mikaelrobertlindberg/elec_RPI_Robot_HAT/production/M2/U8_only_change.png

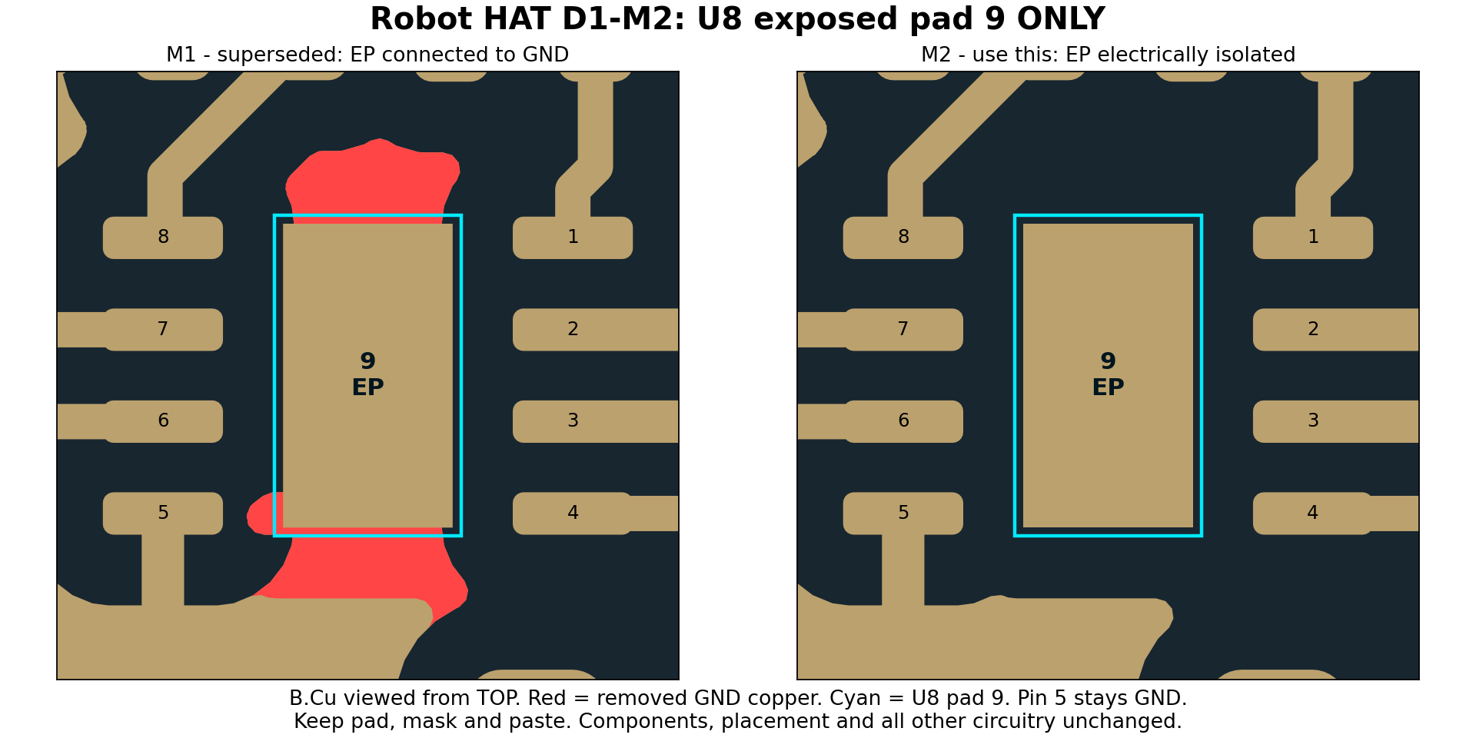
production/M2/U8_only_change.png
