mikaelrobertlindberg/elec_RPI_Robot_HAT/production/M2/BOM_PCBA_10.csv

Item | Designators | Quantity per board | Quantity for 10 boards | Manufacturer | Manufacturer Part Number | Value | Footprint | LCSC Part Number | Source | Source URL | Stock checked | Observed stock | Populate
1 | C1, C2, C3, C4, C6, C10, C27, C29, C31, C33, C35, C40, C41, C42, C43 | 15 | 150 | SAMSUNG(三星) | CL05A105KA5NQNC | 1u | RobotHAT:C_0402_1005Metric_C1 / RobotHAT:C_0402_1005Metric_C10 / RobotHAT:C_0402_1005Metric_C2 / RobotHAT:C_0402_1005Metric_C27 / RobotHAT:C_0402_1005Metric_C29 / RobotHAT:C_0402_1005Metric_C3 / RobotHAT:C_0402_1005Metric_C31 / RobotHAT:C_0402_1005Metric_C33 / RobotHAT:C_0402_1005Metric_C35 / RobotHAT:C_0402_1005Metric_C4 / RobotHAT:C_0402_1005Metric_C40 / RobotHAT:C_0402_1005Metric_C41 / RobotHAT:C_0402_1005Metric_C42 / RobotHAT:C_0402_1005Metric_C43 / RobotHAT:C_0402_1005Metric_C6 | C52923 | LCSC | https://www.lcsc.com/product-detail/C52923.html | 2026-11-09 | 2908400 | YES
2 | C5, C7, C12, C13, C37 | 5 | 50 | SAMSUNG(三星) | CL10A106MQ8NNNC | 10u | RobotHAT:C_0603_1608Metric_C12 / RobotHAT:C_0603_1608Metric_C13 / RobotHAT:C_0603_1608Metric_C37 / RobotHAT:C_0603_1608Metric_C5 / RobotHAT:C_0603_1608Metric_C7 | C1691 | LCSC | https://www.lcsc.com/product-detail/C1691.html | 2026-11-09 | 491910 | YES
3 | C8, C9 | 2 | 20 | muRata(村田) | GRM1555C1H221JA01D | 220p 50V C0G | RobotHAT:C_0402_1005Metric_C8 / RobotHAT:C_0402_1005Metric_C9 | C71693 | LCSC | https://www.lcsc.com/product-detail/C71693.html | 2026-11-09 | 1193500 | YES
4 | C11, C14, C15, C16, C17, C18, C20, C26, C28, C30, C32, C36, C38 | 13 | 130 | SAMSUNG(三星) | CL05B104KB54PNC | 100n / 100n 50V | RobotHAT:C_0402_1005Metric_C11 / RobotHAT:C_0402_1005Metric_C14 / RobotHAT:C_0402_1005Metric_C15 / RobotHAT:C_0402_1005Metric_C16 / RobotHAT:C_0402_1005Metric_C17 / RobotHAT:C_0402_1005Metric_C18 / RobotHAT:C_0402_1005Metric_C20 / RobotHAT:C_0402_1005Metric_C26 / RobotHAT:C_0402_1005Metric_C28 / RobotHAT:C_0402_1005Metric_C30 / RobotHAT:C_0402_1005Metric_C32 / RobotHAT:C_0402_1005Metric_C36 / RobotHAT:C_0402_1005Metric_C38 | C307331 | LCSC | https://www.lcsc.com/product-detail/C307331.html | 2026-11-09 | 2506000 | YES
5 | C19 | 1 | 10 | Panasonic | EEE-FK1J100P | 10u 63V | RobotHAT:Panasonic_FK_D_6.3x5.8_C19 |  | DigiKey | https://www.digikey.se/en/products/detail/panasonic-industry/EEE-FK1J100P/765987 | 2026-11-09 | 14595 | YES
6 | C21, C22 | 2 | 20 | Murata | GRM31CR61C476ME44L | 47u 16V | RobotHAT:C_1206_C21 / RobotHAT:C_1206_C22 | C385047 | LCSC | https://www.lcsc.com/product-detail/C385047.html | 2026-11-09 | 1833 | YES
7 | C23, C24 | 2 | 20 | SAMSUNG(三星) | CL05B104KO5NNNC | 100n 16V | RobotHAT:C_0402_1005Metric_C23 / RobotHAT:C_0402_1005Metric_C24 | C1525 | LCSC | https://www.lcsc.com/product-detail/C1525.html | 2026-11-09 | 3026000 | YES
8 | C34, C44 | 2 | 20 | SAMSUNG(三星) | CL05B103KB5NNNC | 10n | RobotHAT:C_0402_1005Metric_C34 / RobotHAT:C_0402_1005Metric_C44 | C15195 | LCSC | https://www.lcsc.com/product-detail/C15195.html | 2026-11-09 | 968700 | YES
9 | C39 | 1 | 10 | Murata | GRM21BR71H224KA01L | 220n 50V | RobotHAT:C_0805_C39 | C86042 | LCSC | https://www.lcsc.com/product-detail/C86042.html | 2026-11-09 | 6175 | YES
10 | C45 | 1 | 10 | Chinocera(华瓷) | HGC0805R5106K350NSLJ | 10u 35V | RobotHAT:C_0805_2012Metric_C45 | C33546007 | LCSC | https://www.lcsc.com/product-detail/C33546007.html | 2026-11-09 | 379510 | YES
11 | D1 | 1 | 10 | onsemi | BAT54WT1G | BAT54W | RobotHAT:SOT-323_SC-70_D1 |  | DigiKey | https://www.digikey.se/en/products/detail/onsemi/BAT54WT1G/918320 | 2026-11-09 | 429 | YES
12 | D2 | 1 | 10 | R+O(宏嘉诚) | BZT52B3V3 | 3V3 Zener Diode | RobotHAT:D_SOD-123_D2 | C19077392 | LCSC | https://www.lcsc.com/product-detail/C19077392.html | 2026-11-09 | 270940 | YES
13 | D4 | 1 | 10 | DIODES(美台) | BZT52C5V1S-7-F | 5V1 | RobotHAT:D_SOD-323_D4 | C151348 | LCSC | https://www.lcsc.com/product-detail/C151348.html | 2026-11-09 | 56280 | YES
14 | D5 | 1 | 10 | Diodes Incorporated | SBR3U40P1-7 | SBR3U40P1-7 | RobotHAT:D_PowerDI123_D5 | C97127 | LCSC | https://www.lcsc.com/product-detail/C97127.html | 2026-11-09 | 9655 | YES
15 | FB1 | 1 | 10 | muRata(村田) | BLM15AG601SN1D | 0.3A 600R@100MHz | RobotHAT:L_0402_1005Metric_FB1 | C76884 | LCSC | https://www.lcsc.com/product-detail/C76884.html | 2026-11-09 | 748800 | YES
16 | FB2, FB3 | 2 | 20 | muRata(村田) | BLM15PX121SN1D | 2A - 120R@100MHz | RobotHAT:L_0402_1005Metric_FB2 / RobotHAT:L_0402_1005Metric_FB3 | C88970 | DigiKey | https://www.digikey.se/en/products/detail/murata-electronics/BLM15PX121SN1D/4421095 | 2026-11-09 | 173030 | YES
17 | J1, J2, J9 | 3 | 30 | DORABO(地博电气) | DB125-2.54-2P-GN-S | Screw term. | RobotHAT:CONN-TH_DB125-2.54-2P-GN_J1 / RobotHAT:CONN-TH_DB125-2.54-2P-GN_J2 / RobotHAT:CONN-TH_DB125-2.54-2P-GN_J9 | C918120 | LCSC | https://www.lcsc.com/product-detail/C918120.html | 2026-11-09 | 28940 | YES
18 | J3, J11 | 2 | 20 | JST | B4B-EH-A(LF)(SN) | Dynamixel-4 | RobotHAT:JST_EH_B4B-EH-A_1x04_P2.50mm_Vertical_J11 / RobotHAT:JST_EH_B4B-EH-A_1x04_P2.50mm_Vertical_J3 | C160258 | LCSC | https://www.lcsc.com/product-detail/C160258.html | 2026-11-09 | 42240 | YES
19 | J4 | 1 | 10 | Liansheng(连盛) | FH-00339 | Female Header 2x20 SMD | RobotHAT:PinHeader_2x20_P2.54mm_Vertical_with_rasp_HAT_zero_SMD_connector_J4 | C2685112 | LCSC | https://www.lcsc.com/product-detail/C2685112.html | 2026-11-09 | 8387 | YES
20 | J5, J6, J7, J8 | 4 | 40 | JST | BM04B-SRSS-TB(LF)(SN) | JST SH | RobotHAT:JST_SH_BM04B-SRSS-TB_1x04-1MP_P1.00mm_Vertical_J5 / RobotHAT:JST_SH_BM04B-SRSS-TB_1x04-1MP_P1.00mm_Vertical_J6 / RobotHAT:JST_SH_BM04B-SRSS-TB_1x04-1MP_P1.00mm_Vertical_J7 / RobotHAT:JST_SH_BM04B-SRSS-TB_1x04-1MP_P1.00mm_Vertical_J8 | C160390 | LCSC | https://www.lcsc.com/product-detail/C160390.html | 2026-11-09 | 1645 | YES
21 | J13, J14 | 2 | 20 | JST | B3B-EH-A(LF)(SN) | Dynamixel-3 | RobotHAT:JST_EH_B3B-EH-A_1x03_P2.50mm_Vertical_J13 / RobotHAT:JST_EH_B3B-EH-A_1x03_P2.50mm_Vertical_J14 | C160259 | LCSC | https://www.lcsc.com/product-detail/C160259.html | 2026-11-09 | 73430 | YES
22 | L4 | 1 | 10 | Eaton | SDCHA1V6045-4R7-R | 4u7 4.5A | RobotHAT:Eaton_SDCHA1V6045_L4 |  | DigiKey | https://www.digikey.se/en/products/detail/eaton-electronics-division/SDCHA1V6045-4R7-R/15926156 | 2026-11-09 | 4455 | YES
23 | MK1 | 1 | 10 | LinkMems(聆麦声学) | LMA2718T421-OA5-2 | Microphone_MEMS | RobotHAT:MIC-SMD_4P-L2.8-W1.9-P1.84-TL_MK1 | C7587901 | LCSC | https://www.lcsc.com/product-detail/C7587901.html | 2026-11-09 | 9870 | YES
24 | Q1 | 1 | 10 | TWGMC(迪嘉) | MMBT3906 | MMBT3906 | RobotHAT:SOT-23_Q1 | C727128 | LCSC | https://www.lcsc.com/product-detail/C727128.html | 2026-11-09 | 313450 | YES
25 | Q2 | 1 | 10 | Diodes Incorporated | DMN3023L-7 | DMN3023L-7 | RobotHAT:TSOT-23_Q2 | C443825 | LCSC | https://www.lcsc.com/product-detail/C443825.html | 2026-11-09 | 7645 | YES
26 | R1, R2, R6, R12, R13, R20, R21, R24, R26, R27, R29, R31, R32, R34, R35, R38, R39 | 17 | 170 | UNI-ROYAL(厚声) | 0402WGF1002TCE | 10k | RobotHAT:R_0402_1005Metric_R1 / RobotHAT:R_0402_1005Metric_R12 / RobotHAT:R_0402_1005Metric_R13 / RobotHAT:R_0402_1005Metric_R2 / RobotHAT:R_0402_1005Metric_R20 / RobotHAT:R_0402_1005Metric_R21 / RobotHAT:R_0402_1005Metric_R24 / RobotHAT:R_0402_1005Metric_R26 / RobotHAT:R_0402_1005Metric_R27 / RobotHAT:R_0402_1005Metric_R29 / RobotHAT:R_0402_1005Metric_R31 / RobotHAT:R_0402_1005Metric_R32 / RobotHAT:R_0402_1005Metric_R34 / RobotHAT:R_0402_1005Metric_R35 / RobotHAT:R_0402_1005Metric_R38 / RobotHAT:R_0402_1005Metric_R39 / RobotHAT:R_0402_1005Metric_R6 | C25744 | LCSC | https://www.lcsc.com/product-detail/C25744.html | 2026-11-09 | 1442800 | YES
27 | R3, R4, R5, R7, R9, R14, R15, R18, R19, R25, R30, R40 | 12 | 120 | UNI-ROYAL(厚声) | 0402WGF0000TCE | 0R | RobotHAT:R_0402_1005Metric_R14 / RobotHAT:R_0402_1005Metric_R15 / RobotHAT:R_0402_1005Metric_R18 / RobotHAT:R_0402_1005Metric_R19 / RobotHAT:R_0402_1005Metric_R25 / RobotHAT:R_0402_1005Metric_R3 / RobotHAT:R_0402_1005Metric_R30 / RobotHAT:R_0402_1005Metric_R4 / RobotHAT:R_0402_1005Metric_R40 / RobotHAT:R_0402_1005Metric_R5 / RobotHAT:R_0402_1005Metric_R7 / RobotHAT:R_0402_1005Metric_R9 | C17168 | LCSC | https://www.lcsc.com/product-detail/C17168.html | 2026-11-09 | 8561100 | YES
28 | R22, R23 | 2 | 20 | YAGEO(国巨) | RC0402FR-074K7L | 4k7 | RobotHAT:R_0402_1005Metric_R22 / RobotHAT:R_0402_1005Metric_R23 | C105871 | LCSC | https://www.lcsc.com/product-detail/C105871.html | 2026-11-09 | 11573800 | YES
29 | R28 | 1 | 10 | UNI-ROYAL(厚声) | 0402WGF2002TCE | 20k | RobotHAT:R_0402_1005Metric_R28 | C25765 | LCSC | https://www.lcsc.com/product-detail/C25765.html | 2026-11-09 | 699600 | YES
30 | R33 | 1 | 10 | FOJAN(富捷) | FRC0402F1500TS | 150R | RobotHAT:R_0402_1005Metric_R33 | C2909321 | LCSC | https://www.lcsc.com/product-detail/C2909321.html | 2026-11-09 | 867900 | YES
31 | R42 | 1 | 10 | YAGEO(国巨) | RC0402JR-071KL | 1k | RobotHAT:R_0402_1005Metric_R42 | C105637 | LCSC | https://www.lcsc.com/product-detail/C105637.html | 2026-11-09 | 17128500 | YES
32 | TH1 | 1 | 10 | muRata(村田) | PRG18BB101MB1RB | 100R thermistor | RobotHAT:R_0603_1608Metric_TH1 | C913703 | LCSC | https://www.lcsc.com/product-detail/C913703.html | 2026-11-09 | 1935 | YES
33 | U1 | 1 | 10 | DIODES(美台) | PAM8406DR | PAM8406D | RobotHAT:SOIC-16_3.9x9.9mm_P1.27mm_U1 | C86270 | LCSC | https://www.lcsc.com/product-detail/C86270.html | 2026-11-09 | 20597 | YES
34 | U2 | 1 | 10 | TI(德州仪器) | TLV320AIC3104IRHBR | TLV320AIC3104IRHBR | RobotHAT:VQFN-32-1EP_5x5mm_P0.5mm_EP3.5x3.5mm_U2 | C181753 | LCSC | https://www.lcsc.com/product-detail/C181753.html | 2026-11-09 | 7355 | YES
35 | U3 | 1 | 10 | UMW(友台半导体) | XC6206P182MR | XC6206P182MR | RobotHAT:SOT-23-3_U3 | C347373 | LCSC | https://www.lcsc.com/product-detail/C347373.html | 2026-11-09 | 53350 | YES
36 | U5 | 1 | 10 | TI(德州仪器) | SN74LVC1G08DBVR | 74LVC1G08 | RobotHAT:SOT-23-5_U5 | C7666 | LCSC | https://www.lcsc.com/product-detail/C7666.html | 2026-11-09 | 86350 | YES
37 | U6 | 1 | 10 | TI(德州仪器) | SN74LVC1G125DBVR | SN74LVC1G125DBV | RobotHAT:SOT-23-5_U6 | C23654 | LCSC | https://www.lcsc.com/product-detail/C23654.html | 2026-11-09 | 182035 | YES
38 | U7 | 1 | 10 | TI(德州仪器) | SN74LVC1G126DBVR | SN74LVC1G126DBVR | RobotHAT:SOT-23-5_U7 | C7834 | LCSC | https://www.lcsc.com/product-detail/C7834.html | 2026-11-09 | 84300 | YES
39 | U8 | 1 | 10 | GATEMODE(捷茂微) | GM3088ENA | GM3088ENA | RobotHAT:DFN-8-1EP_3x3mm_P0.65mm_EP1.2x2.15mm_U8 | C49423279 | LCSC | https://www.lcsc.com/product-detail/C49423279.html | 2026-11-09 | 42380 | YES
40 | U9 | 1 | 10 | DIODES(美台) | AP63205WU-7 | AP63205 | RobotHAT:TSOT-23-6_U9 | C2071056 | LCSC | https://www.lcsc.com/product-detail/C2071056.html | 2026-11-09 | 41129 | YES
41 | U10 | 1 | 10 | Texas Instruments | LM74700QDBVRQ1 | LM74700QDBVRQ1 | RobotHAT:LM74700_DBV_U10 | C2941042 | LCSC | https://www.lcsc.com/product-detail/C2941042.html | 2026-11-09 | 20538 | YES
42 | U12 | 1 | 10 | ST(意法半导体) | LSM6DSV16XTR | LSM6DSV16XTR | RobotHAT:LSM6DSV16X_PCBWay_020_U12 | C5267406 | LCSC | https://www.lcsc.com/product-detail/C5267406.html | 2026-11-09 | 11047 | YES
43 | Y1 | 1 | 10 | YXC(扬兴晶振) | OT3EL89CJI-111YLC-12M | 12 MHz | RobotHAT:Oscillator_SMD_Abracon_ASDMB-4Pin_2.5x2.0mm_Y1 | C7425459 | LCSC | https://www.lcsc.com/product-detail/C7425459.html | 2026-11-09 | 5750 | YES
