mikaelrobertlindberg/elec_RPI_Robot_HAT/production/M2/docs/ROUTING_REPAIR.md

# Power ECO routing verification — 2026-11-09

KiCad9.0.7 final native DRC at13:02:16: **0 violations,0 unconnected items,0 schematic parity findings**, with all severities included. Report: `repair-final-drc.json`. No rule severity, exclusion, project settings or net functions were changed by this routing repair.

## Copper changes

- Removed the new B.Cu +5V loop that crossed ground traces, ground vias and audio test points; removed the regulator-sense via/track that crossed +BATT on F.Cu.
- +5V Q2 drain now has a1mm outer-copper connection to three0.6mm-diameter/0.3mm-drilled through vias near(101.8,79.7/80.4/81.1). A1.8mm inner-copper trunk reaches the original +5V connection at(108.897501,76.740001), supplemented by two additional0.6/0.3 vias near(108.9,75.2/75.9). The upper branch near TP4 uses0.6mm fan-out width; it carries one of three parallel via currents rather than the entire2A load.
- REG_5V main connection between L4 output copper and Q2 source retains1mm outer-copper width and now has three0.6/0.3 vias near(101.7,82.5/83.0/83.5). No single0.2mm drill is relied upon for this new main power transition.
- U10 ground escapes through its body corridor to a local ground via at(104.65,75.9), clear of the SW trace and adjacent gate/VCAP pads.
- U10 ANODE/EN and C39's ANODE-side return connect to the L4 output/Q2-source net through a narrow sense route and a local REG_5V via at(106.4,82.4).
- D1 cathode joins the sensed regulator output through a via near(98.8,81.4), without crossing VIN copper.
- Both output-capacitor ground pads receive direct0.6/0.3 ground vias at(97.925,82.9) and(93.025,82.9). This connects the bottom-edge ground pour that the new power traces had isolated and shortens capacitor return paths.
- U8 EP pad9 is assigned GND to match the revised exact-part symbol. The unnumbered paste-only aperture was retained.
- L4's six assembly-outline segments that printed over the enlarged exposed lands were moved to F.Fab, preserving their assembly information while eliminating silkscreen-over-mask findings. Its local footprint copy was updated to match.

## Metadata correction caught by native parity

The first routing-clean report exposed52 remaining DNP mismatches despite individual audio symbols having `(dnp no)`. The complete Audio hierarchical sheet had inadvertently become `(dnp yes)` during an earlier schema metadata edit. This was corrected by the parent agent, rather than copying that erroneous population state to the PCB. Only the intended six logo/test-point DNP flags were synchronized on the PCB. Native parity subsequently became0.

## Thermal and return-path interpretation

Outer main power traces are1mm on35um copper. The inner main trunk is1.8mm on18um copper, giving a comparable copper cross-section. Via groups contain three0.3mm drilled barrels per transition; actual current sharing and final copper plating remain manufacturing-dependent. Native checks do not establish a thermal rating or replace a2A load/temperature test.

At the13:02 routing snapshot, the +5V trunk occupies In1.Cu and the narrow REG_5V sense route occupies In2.Cu. The parent was advised that swapping those two **new** route layer assignments, followed by refill and full DRC, would leave the nearest In1 ground reference more continuous beneath the F.Cu SW region and put the broader +5V trunk behind that reference. If that recommendation is applied, the parent's final release reports supersede this routing snapshot.

## Handoff

PCB ownership returned to the parent after the0/0/0 result. No commit was made by this worker. `route_repair_stage2.py` through`stage5.py`, `repair_routes_native.py` and `sync_board_dnp.py` are one-off investigative repair scripts, not a manufacturing release pipeline; they should not be blindly rerun on the final board. Original upstream netclass clearance0.15mm and the dedicated U12 0.19mm constraint were retained.
