mikaelrobertlindberg/elec_RPI_Robot_HAT/production/M2/Robot_HAT_M2_assembly_bottom.pdf

# Robot HAT D1-M2 - bottom assembly

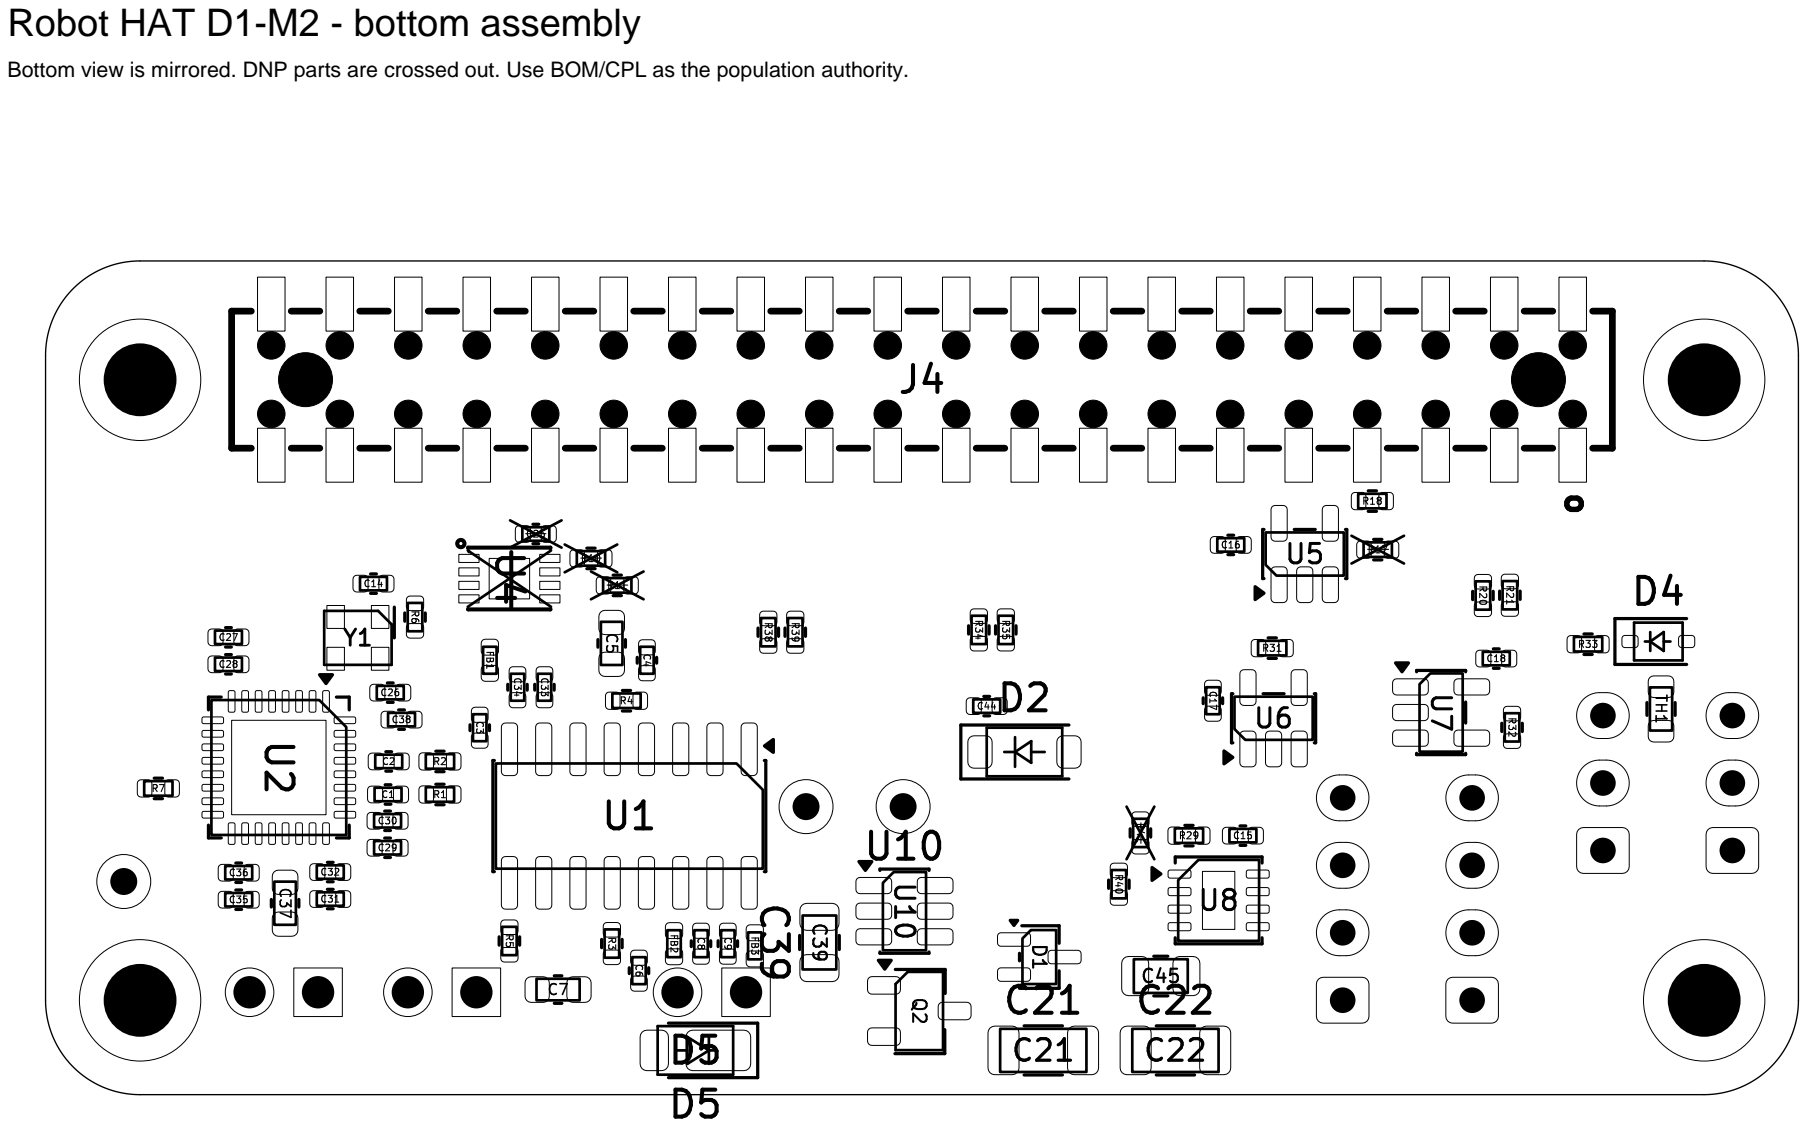
[picture p2: page 1]

Bottom view is mirrored. DNP parts are crossed out. Use BOM/CPL as the population authority.
