mikaelrobertlindberg/elec_RPI_Robot_HAT/production/M2/Robot_HAT_M2_assembly_top.pdf

# Robot HAT D1-M2 - top assembly

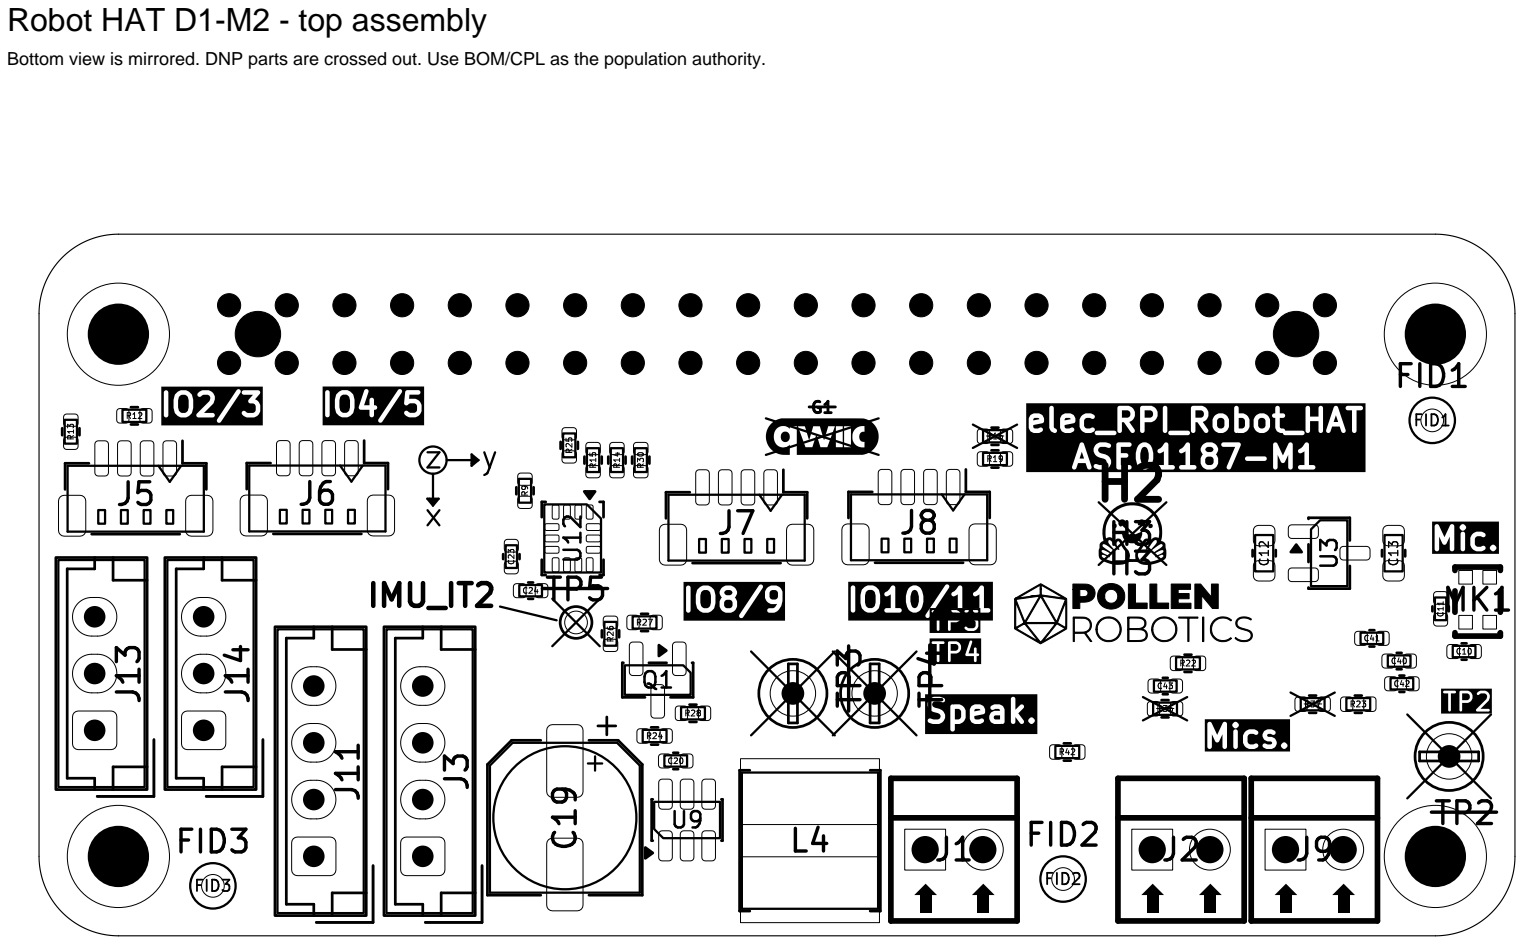
[picture p3: page 1]

Bottom view is mirrored. DNP parts are crossed out. Use BOM/CPL as the population authority.
