mikaelrobertlindberg/elec_RPI_Robot_HAT/production/M2/Robot_HAT_M2_schematic.pdf

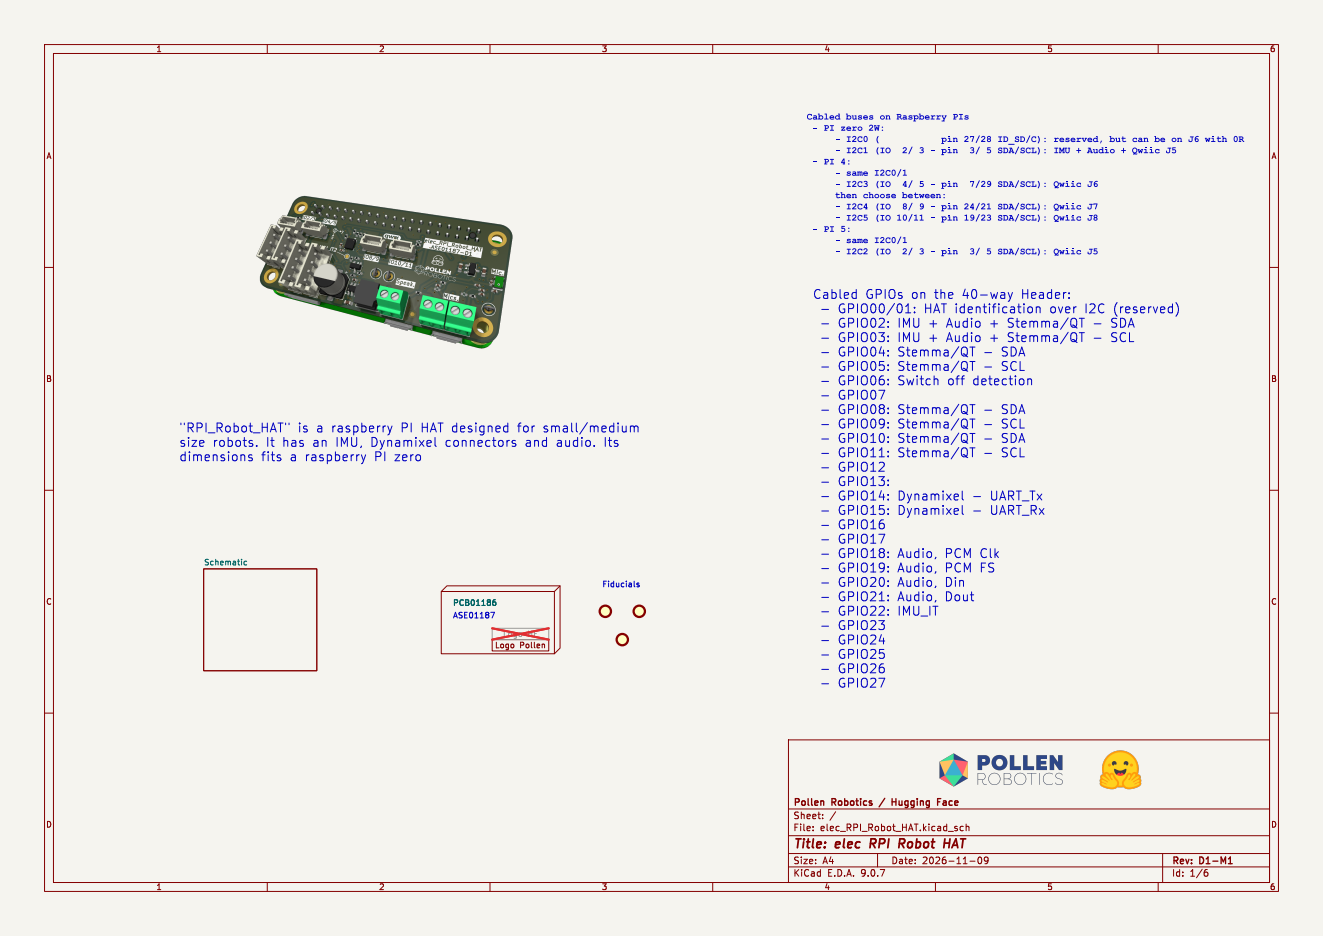
[picture p4: page 1]

Cabled buses on Raspberry PIs
- PI zero 2W:
- same I2C0/1
then choose between:
- I2C5 (IO 10/11 - pin 19/23 SDA/SCL): Qwiic J8

Id: 1/6 Title: elec RPI Robot HAT

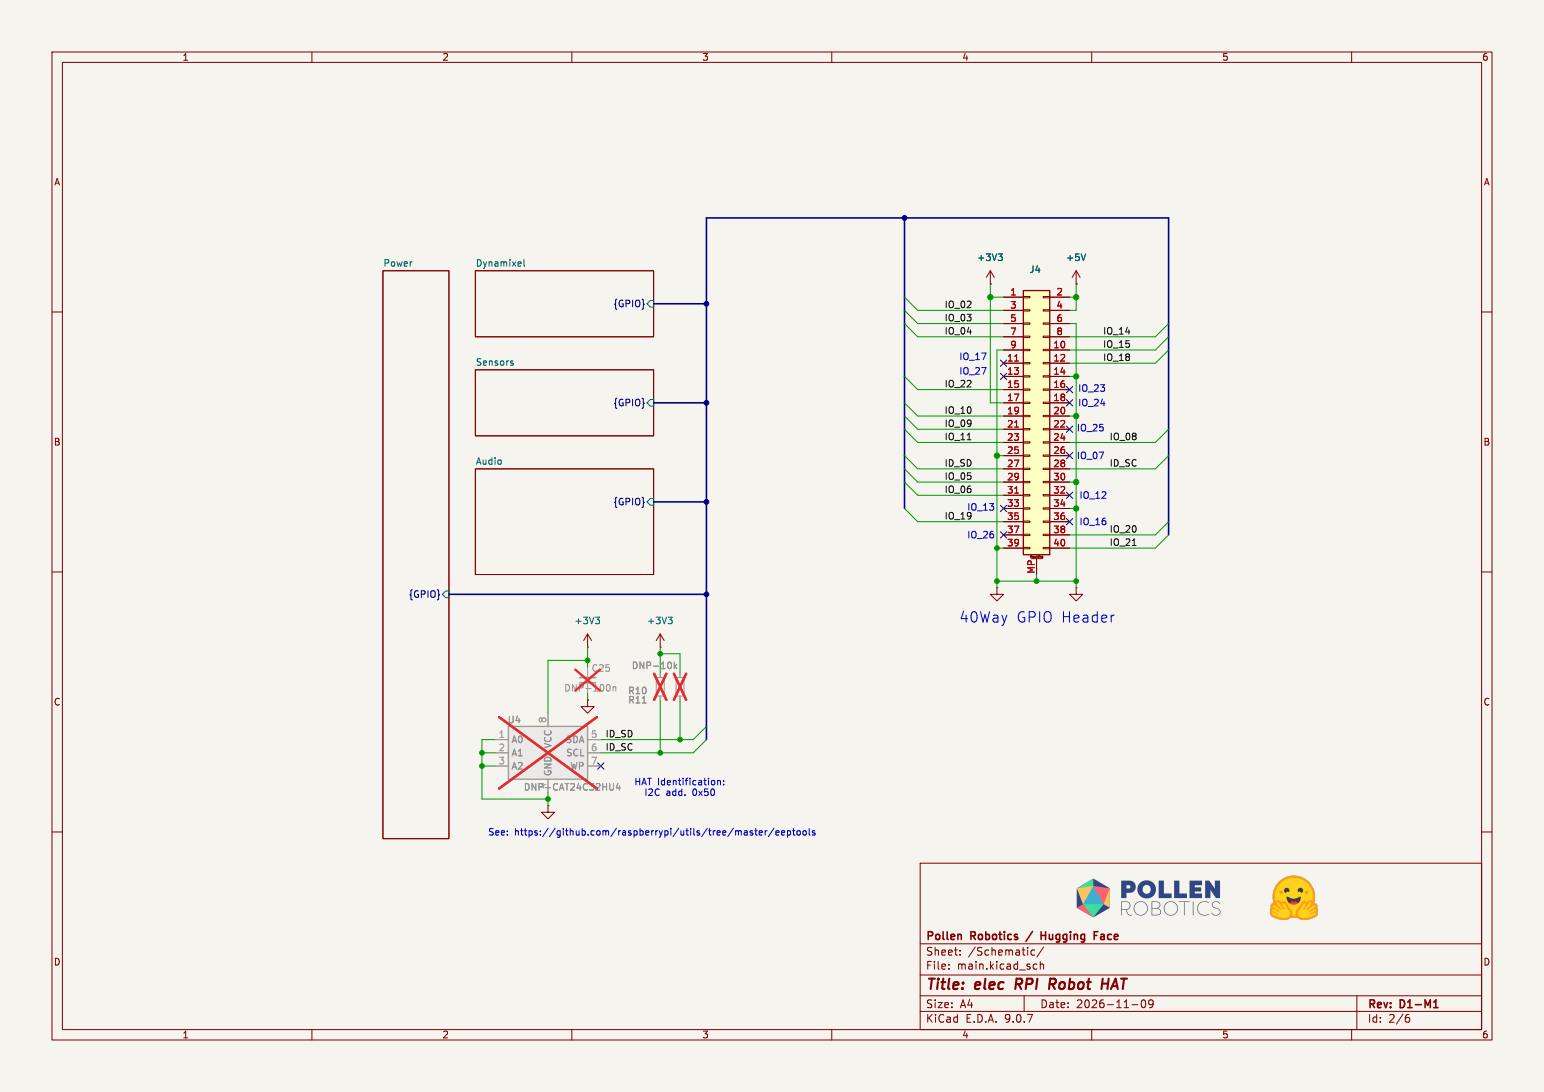
[picture p5: page 2]

I2C add. 0x50 See: https://github.com/raspberrypi/utils/tree/master/eeptools

Id: 2/6 Title: elec RPI Robot HAT

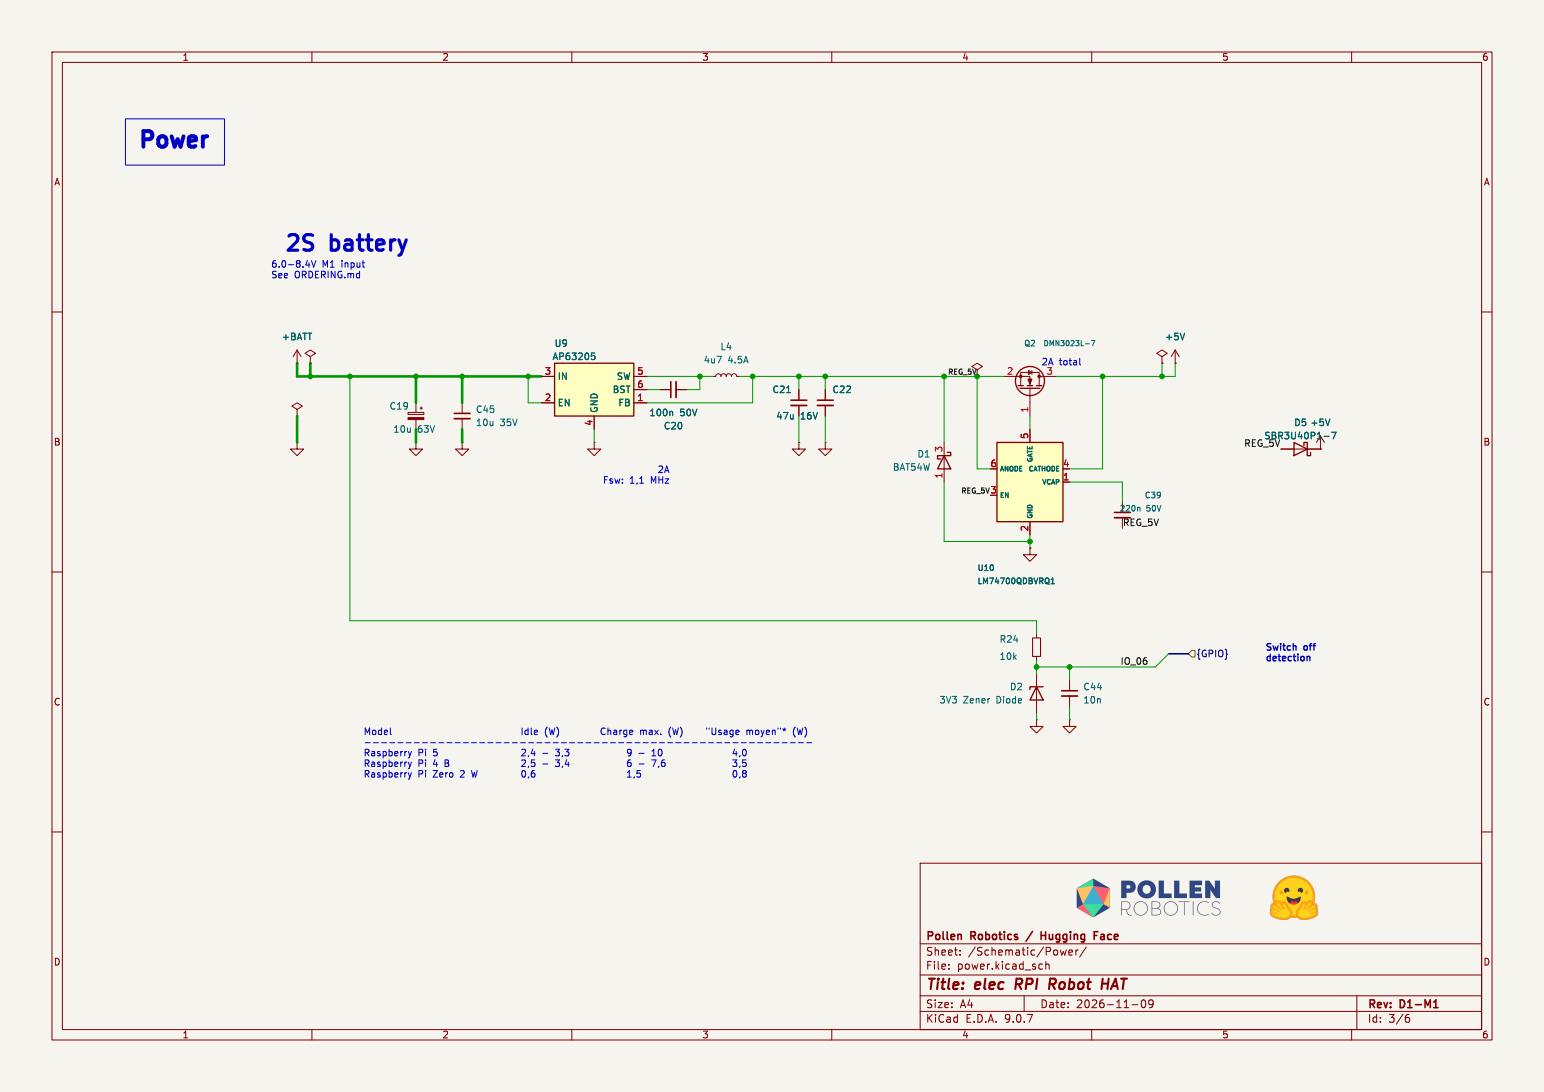
[picture p6: page 3]

Id: 3/6 Title: elec RPI Robot HAT

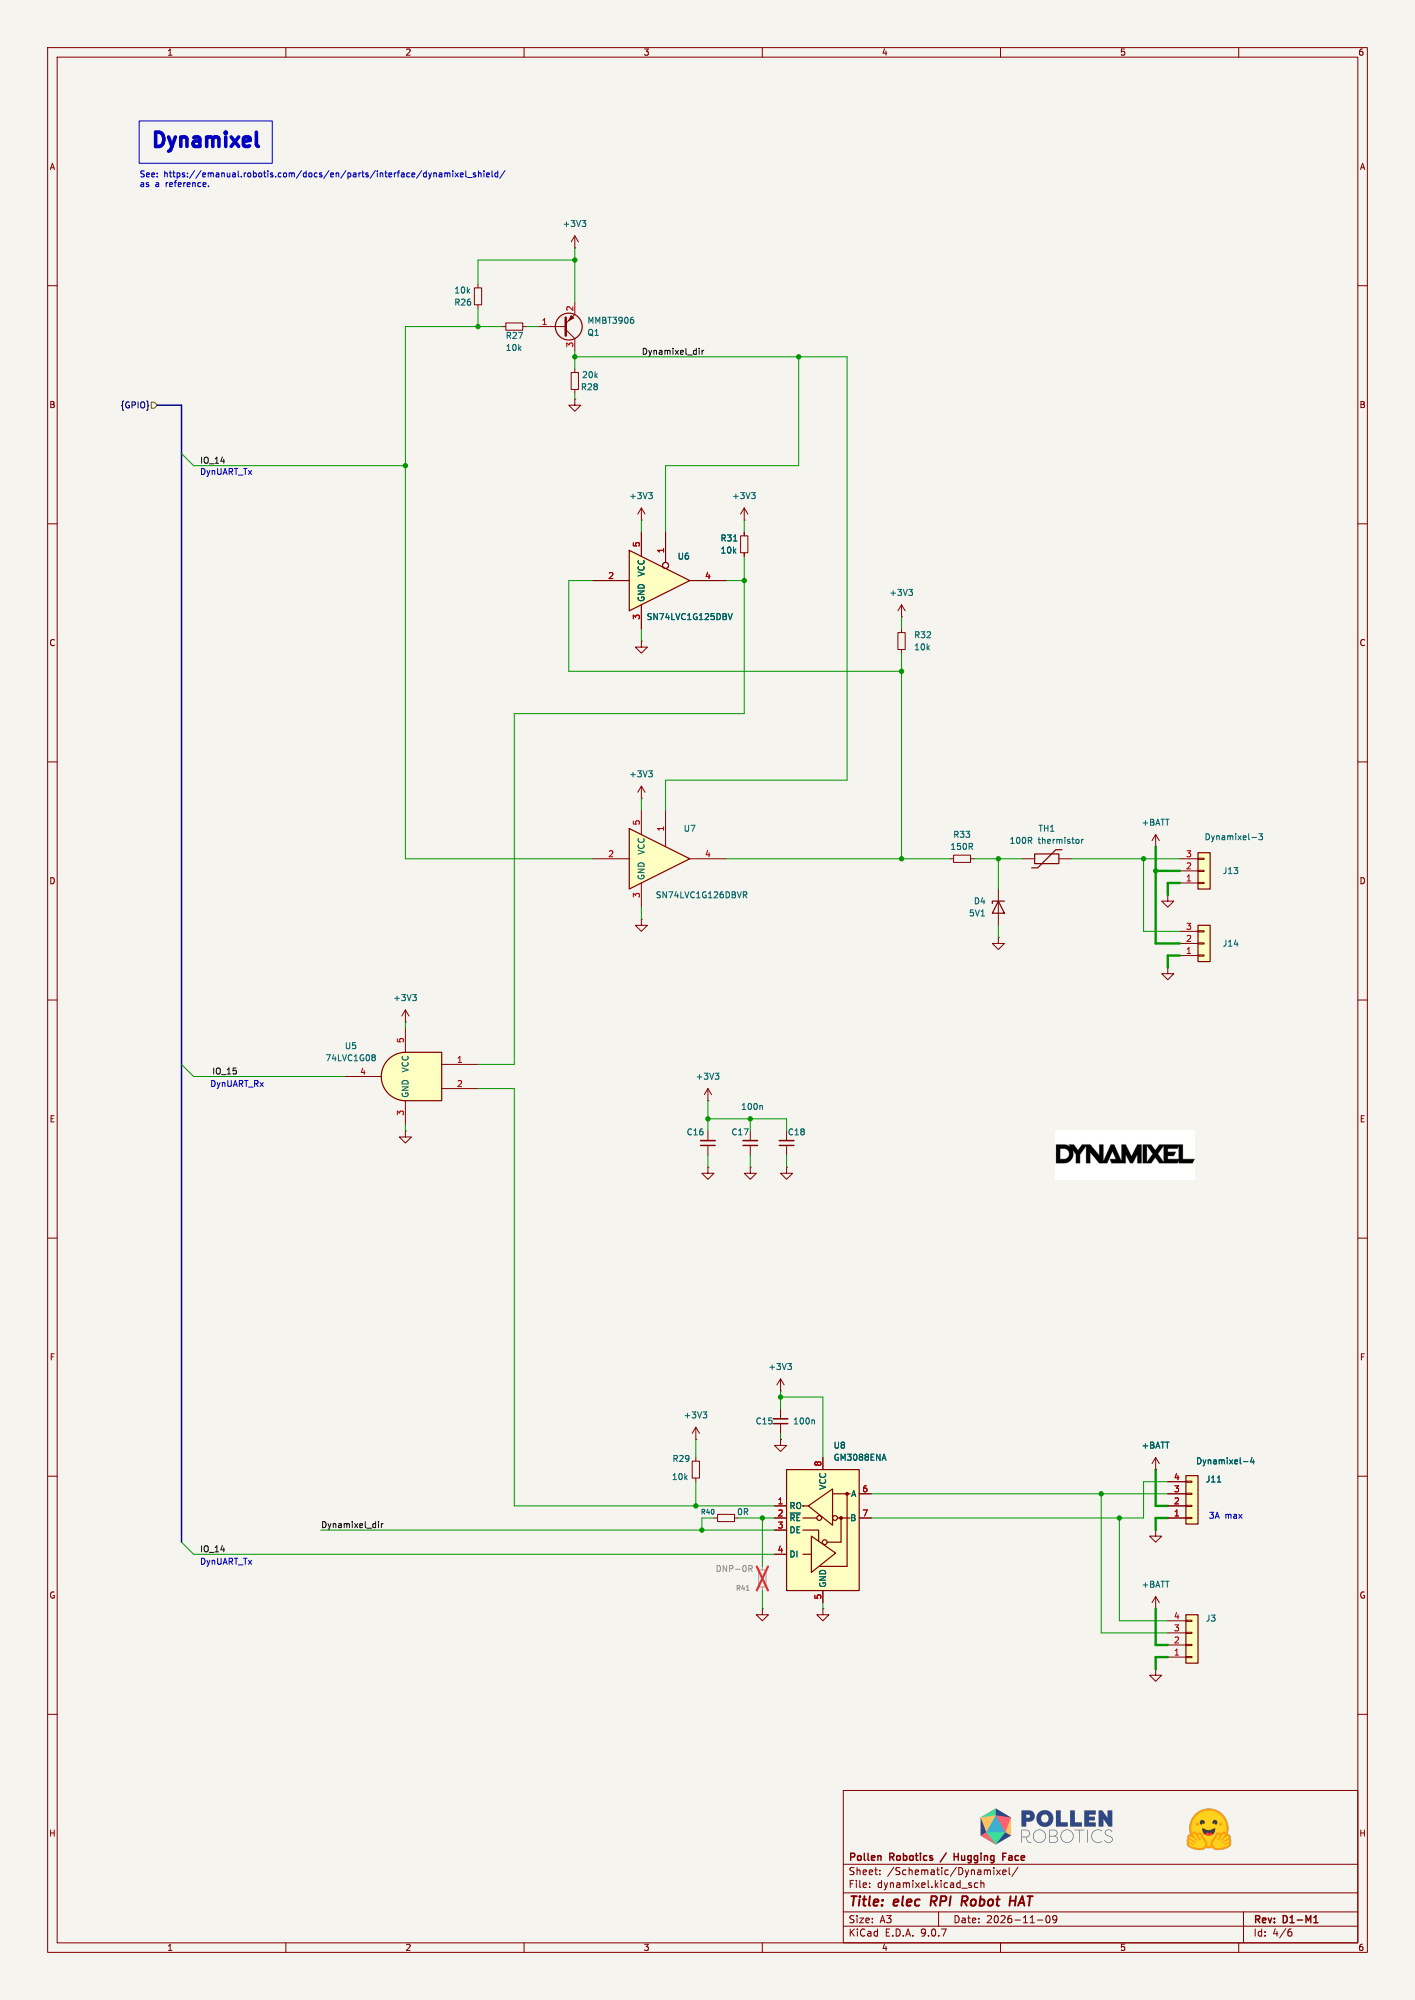
[picture p7: page 4]

See: https://emanual.robotis.com/docs/en/parts/interface/dynamixel_shield/ as a reference.

Id: 4/6 Title: elec RPI Robot HAT

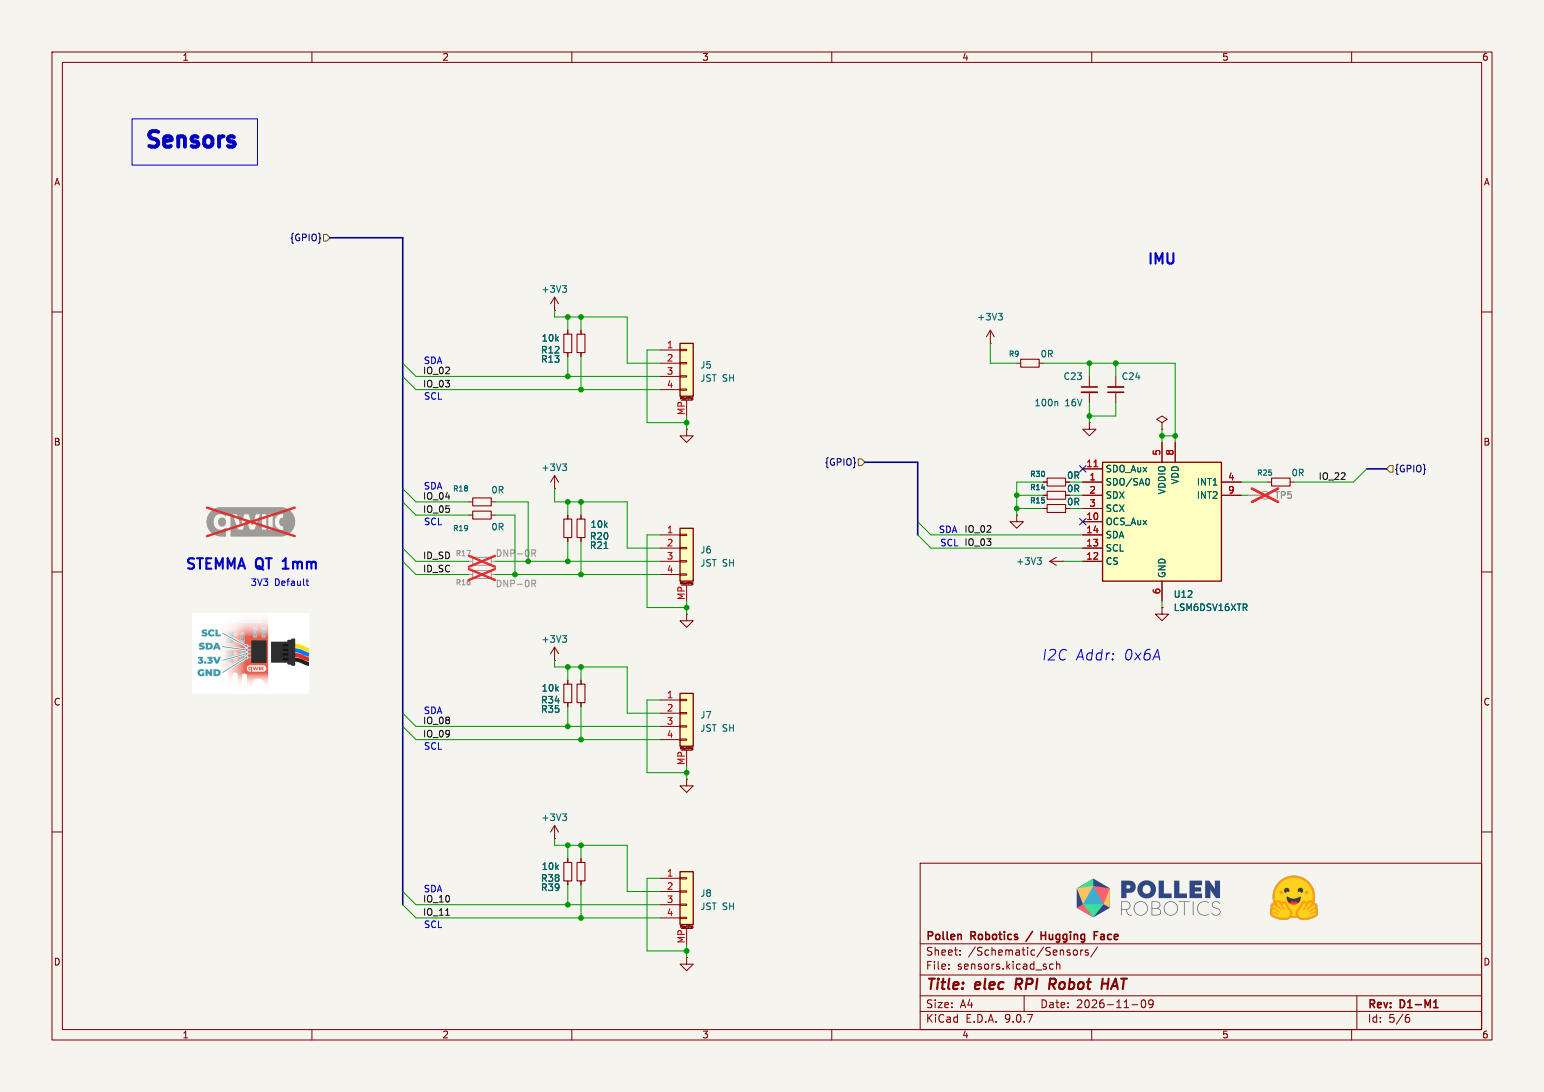
[picture p8: page 5]

Id: 5/6 Title: elec RPI Robot HAT

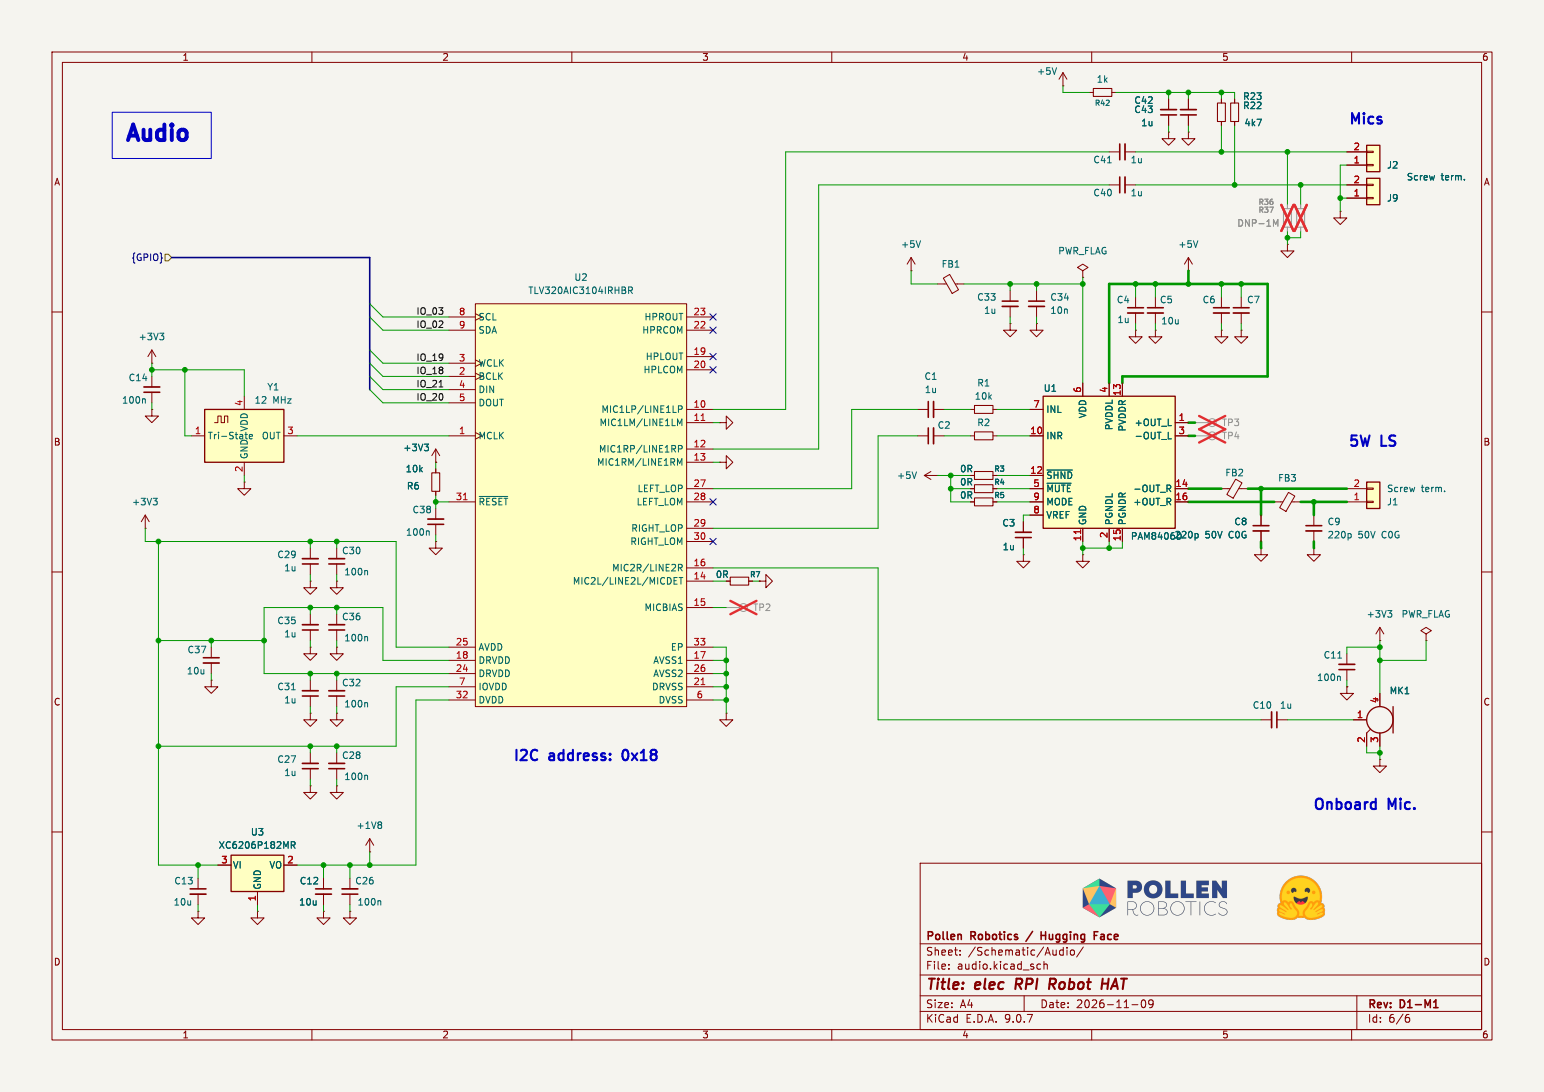
[picture p9: page 6]

Id: 6/6 Title: elec RPI Robot HAT
