mikaelrobertlindberg/elec_RPI_Robot_HAT/production/M1/Robot_HAT_M1_assembly_bottom.pdf

# Robot HAT D1-M1 - bottom assembly

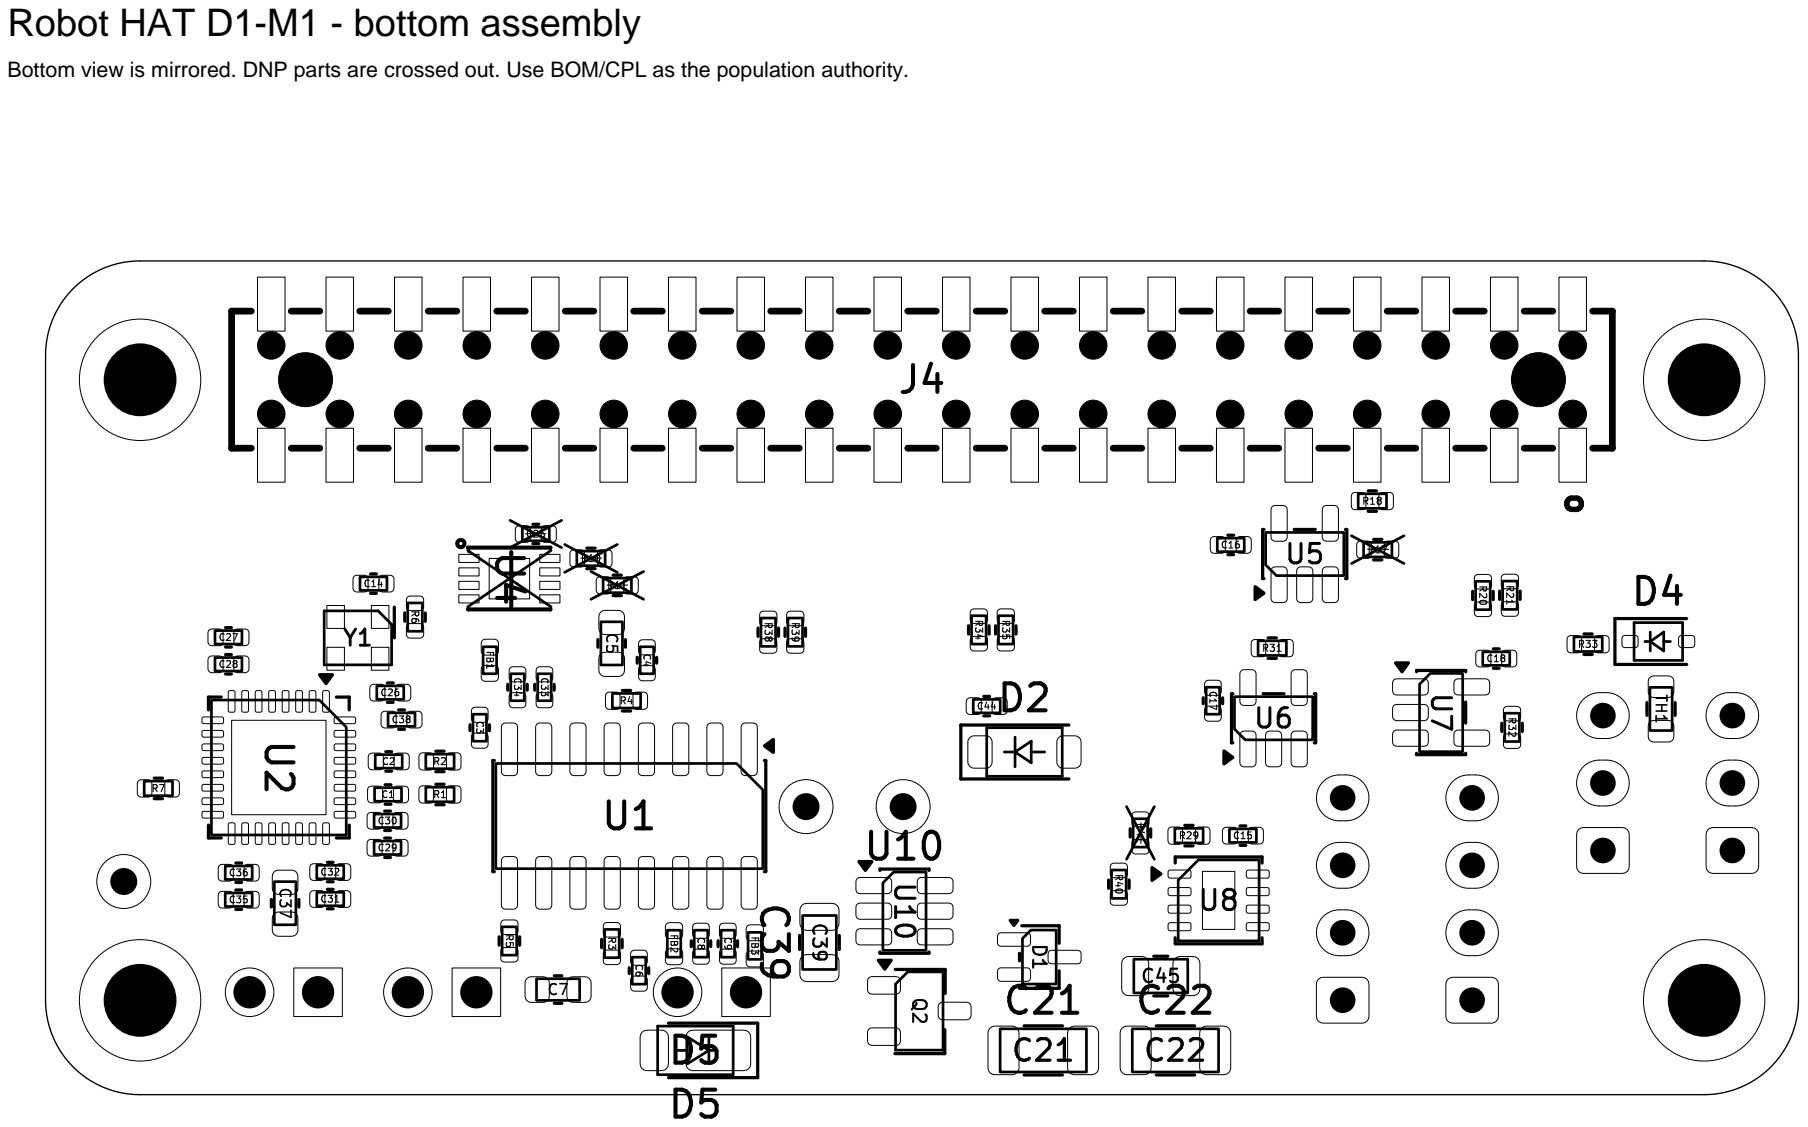
[picture p10: page 1]

Bottom view is mirrored. DNP parts are crossed out. Use BOM/CPL as the population authority.
