mikaelrobertlindberg/elec_RPI_Robot_HAT/production/M1/Robot_HAT_M1_assembly_top.pdf

# Robot HAT D1-M1 - top assembly

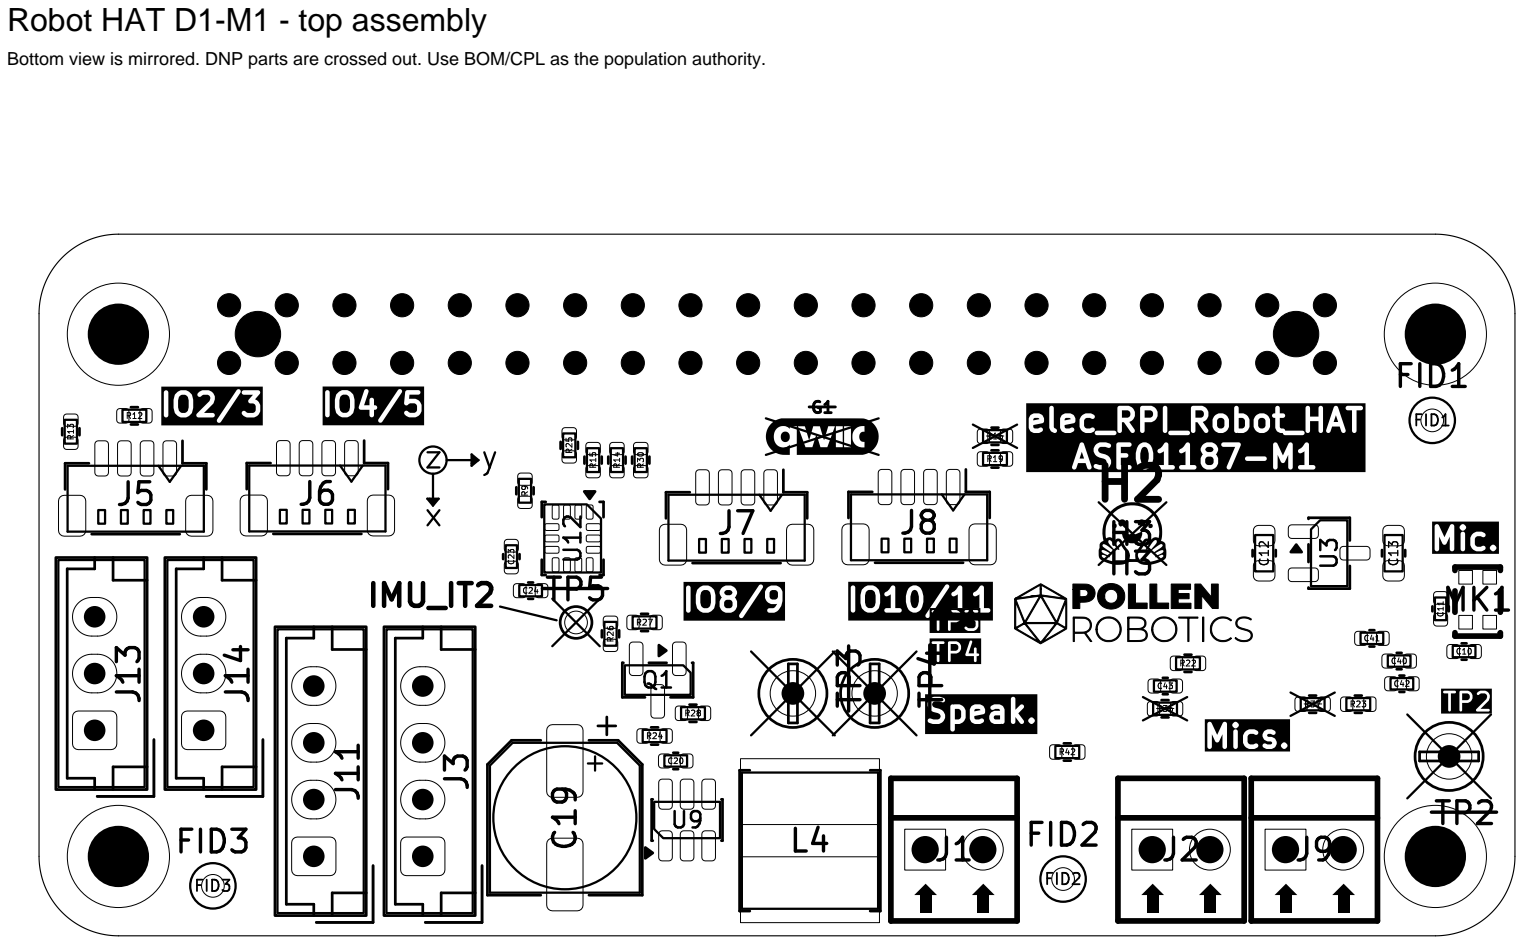
[picture p11: page 1]

Bottom view is mirrored. DNP parts are crossed out. Use BOM/CPL as the population authority.
