mikaelrobertlindberg/elec_RPI_Robot_HAT/production/M1/Robot_HAT_M1_schematic.pdf

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

Id: 1/6 Title: elec RPI Robot HAT


I2C add. 0x50 See: https://github.com/raspberrypi/utils/tree/master/eeptools

Id: 2/6 Title: elec RPI Robot HAT


Id: 3/6 Title: elec RPI Robot HAT

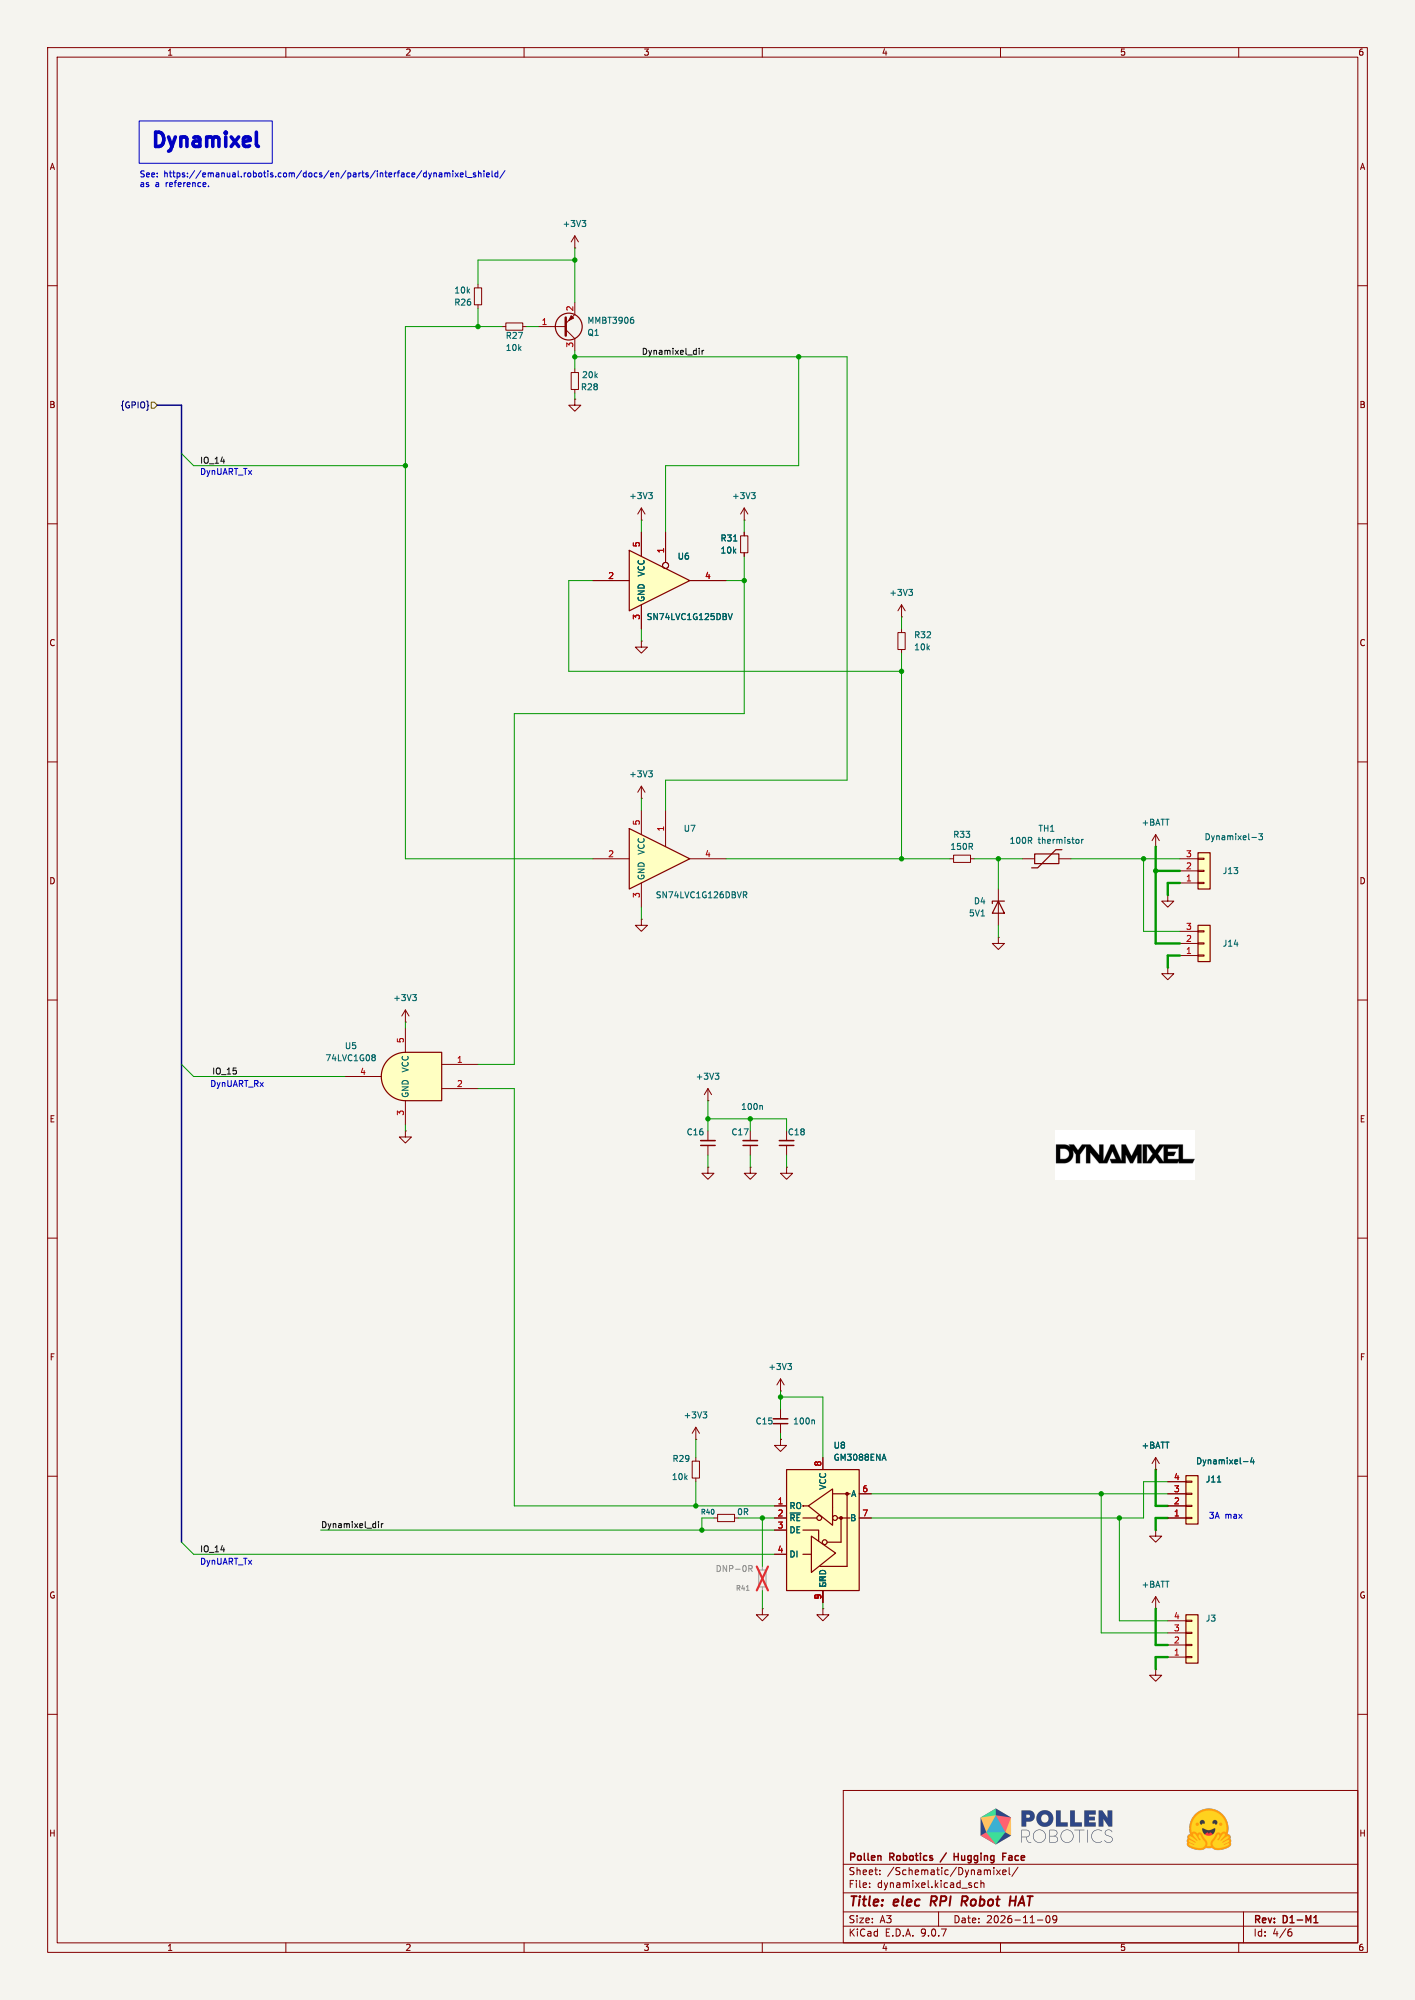
[picture p12: page 4]

See: https://emanual.robotis.com/docs/en/parts/interface/dynamixel_shield/ as a reference.

Id: 4/6 Title: elec RPI Robot HAT


Id: 5/6 Title: elec RPI Robot HAT


Id: 6/6 Title: elec RPI Robot HAT
