mikaelrobertlindberg/elec_RPI_Robot_HAT/elec_RPI_Robot_HAT.kicad_pcb

## KiCad design elec_RPI_Robot_HAT.kicad_pcb (2026-11-11)

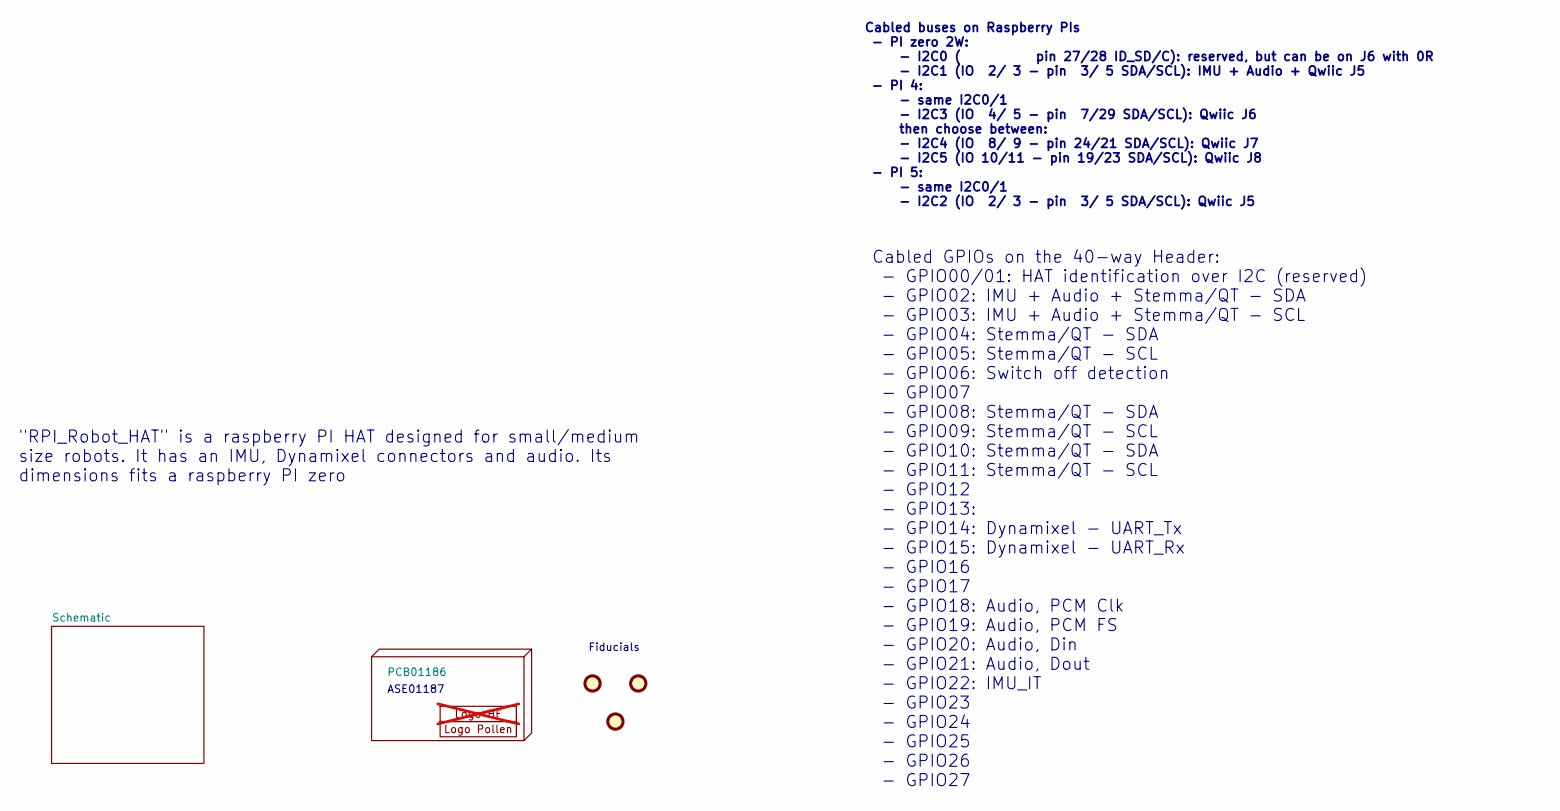
[picture p13: schematic elec_RPI_Robot_HAT.kicad_sch, elec RPI Robot HAT]

Parts:
FID1: DNP Fiducial; Fiducial_1mm_Mask2mm_FID1
FID2: DNP Fiducial; Fiducial_1mm_Mask2mm_FID2
FID3: DNP Fiducial; Fiducial_1mm_Mask2mm_FID3
H1: PCB01186
H2: Logo HF 2025; Logo_HF_2025_H2; not fitted
H3: DNP Logo Pollen 2021; Logo_Pollen_2021_sq_H3

Notes on the sheet:
Fiducials
Cabled buses on Raspberry PIs - PI zero 2W: - I2C0 ( pin 27/28 ID_SD/C): reserved, but can be on J6 with 0R - I2C1 (IO 2/ 3 - pin 3/ 5 SDA/SCL): IMU + Audio + Qwiic J5 - PI 4: - same I2C0/1 - I2C3 (IO 4/ 5 - pin 7/29 SDA/SCL): Qwiic J6 then choose between: - I2C4 (IO 8/ 9 - pin 24/21 SDA/SCL): Qwii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
ASE01187
"RPI_Robot_HAT" is a raspberry PI HAT designed for small/medium size robots. It has an IMU, Dynamixel connectors and audio. Its dimensions fits a raspberry PI zero
Cabled GPIOs on the 40-way Header: - GPIO00/01: HAT identification over I2C (reserved) - GPIO02: IMU + Audio + Stemma/QT - SDA - GPIO03: IMU + Audio + Stemma/QT - SCL - GPIO04: Stemma/QT - SDA - GPIO05: Stemma/QT - SCL - GPIO06: Switch off detection - GPIO07 - GPIO08: Stemma/QT - SDA - GPIO09: Stem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

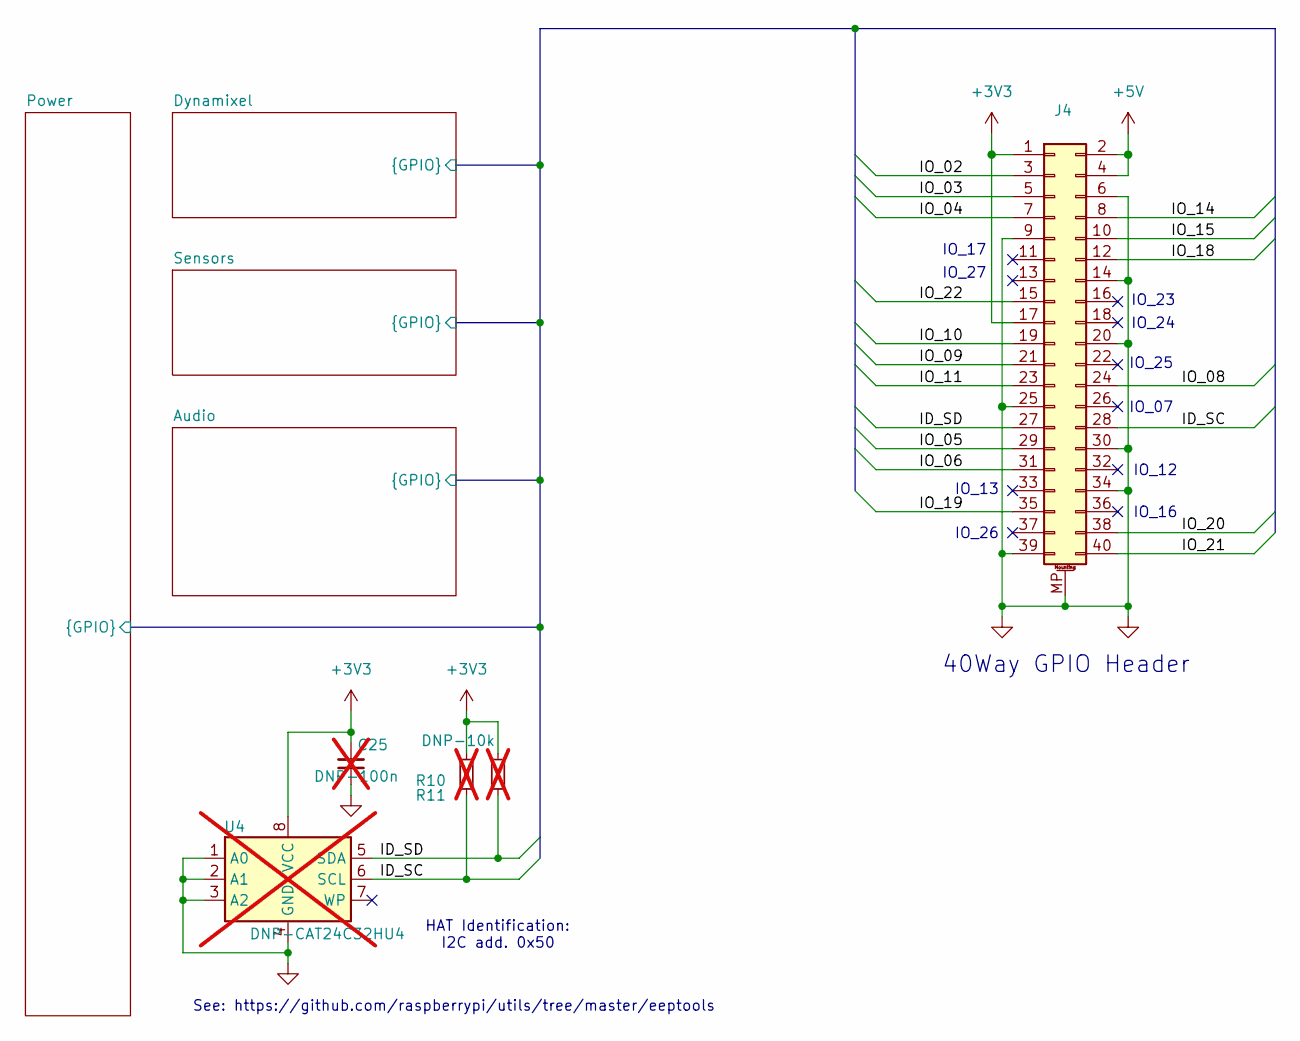
[picture p14: schematic main.kicad_sch, elec RPI Robot HAT]

Parts:
C25: DNP-100n; C_0402_1005Metric_C25; not fitted
J4: Female Header 2x20 SMD; PinHeader_2x20_P2.54mm_Vertical_with_rasp_HAT_zero_SMD_conn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; Part Description PinHeader_2x20_P2.54mm_Vertical; LCSC Part C2685112
R10: DNP-10k; R_0402_1005Metric_R10; not fitted
R11: DNP-10k; R_0402_1005Metric_R11; not fitted
U4: DNP-CAT24C32HU4; TDFN-8_L3.0-W2.0-P0.50-BL-EP_U4; not fitted

Connections:
+3V3: C25.2, J4.1, J4.17, R10.1, R11.1, U4.8 (VCC); also elsewhere on the board
+5V: J4.2, J4.4; also elsewhere on the board
/Schematic/Audio/ID_SC: J4.28, R10.2, U4.6 (SCL); also elsewhere on the board
/Schematic/Audio/ID_SD: J4.27, R11.2, U4.5 (SDA); also elsewhere on the board
/Schematic/Audio/IO_02: J4.3; also elsewhere on the board
/Schematic/Audio/IO_03: J4.5; also elsewhere on the board
/Schematic/Audio/IO_04: J4.7; also elsewhere on the board
/Schematic/Audio/IO_05: J4.29; also elsewhere on the board
/Schematic/Audio/IO_06: J4.31; also elsewhere on the board
/Schematic/Audio/IO_08: J4.24; also elsewhere on the board
/Schematic/Audio/IO_09: J4.21; also elsewhere on the board
/Schematic/Audio/IO_10: J4.19; also elsewhere on the board
/Schematic/Audio/IO_11: J4.23; also elsewhere on the board
/Schematic/Audio/IO_14: J4.8; also elsewhere on the board
/Schematic/Audio/IO_15: J4.10; also elsewhere on the board
/Schematic/Audio/IO_18: J4.12; also elsewhere on the board
/Schematic/Audio/IO_19: J4.35; also elsewhere on the board
/Schematic/Audio/IO_20: J4.38; also elsewhere on the board
/Schematic/Audio/IO_21: J4.40; also elsewhere on the board
/Schematic/Audio/IO_22: J4.15; also elsewhere on the board
GND: C25.1, J4.6, J4.9, J4.14, J4.20, J4.25, J4.30, J4.34, J4.39, J4.MP (MountPin), U4.1 (A0), U4.2 (A1), U4.3 (A2), U4.4 (GND); also elsewhere on the board

Notes on the sheet:
IO_07
IO_23
40Way GPIO Header
IO_13
IO_24
HAT Identification: I2C add. 0x50
IO_25
IO_17
IO_12
See: https://github.com/raspberrypi/utils/tree/master/eeptools
IO_16
IO_26
IO_27

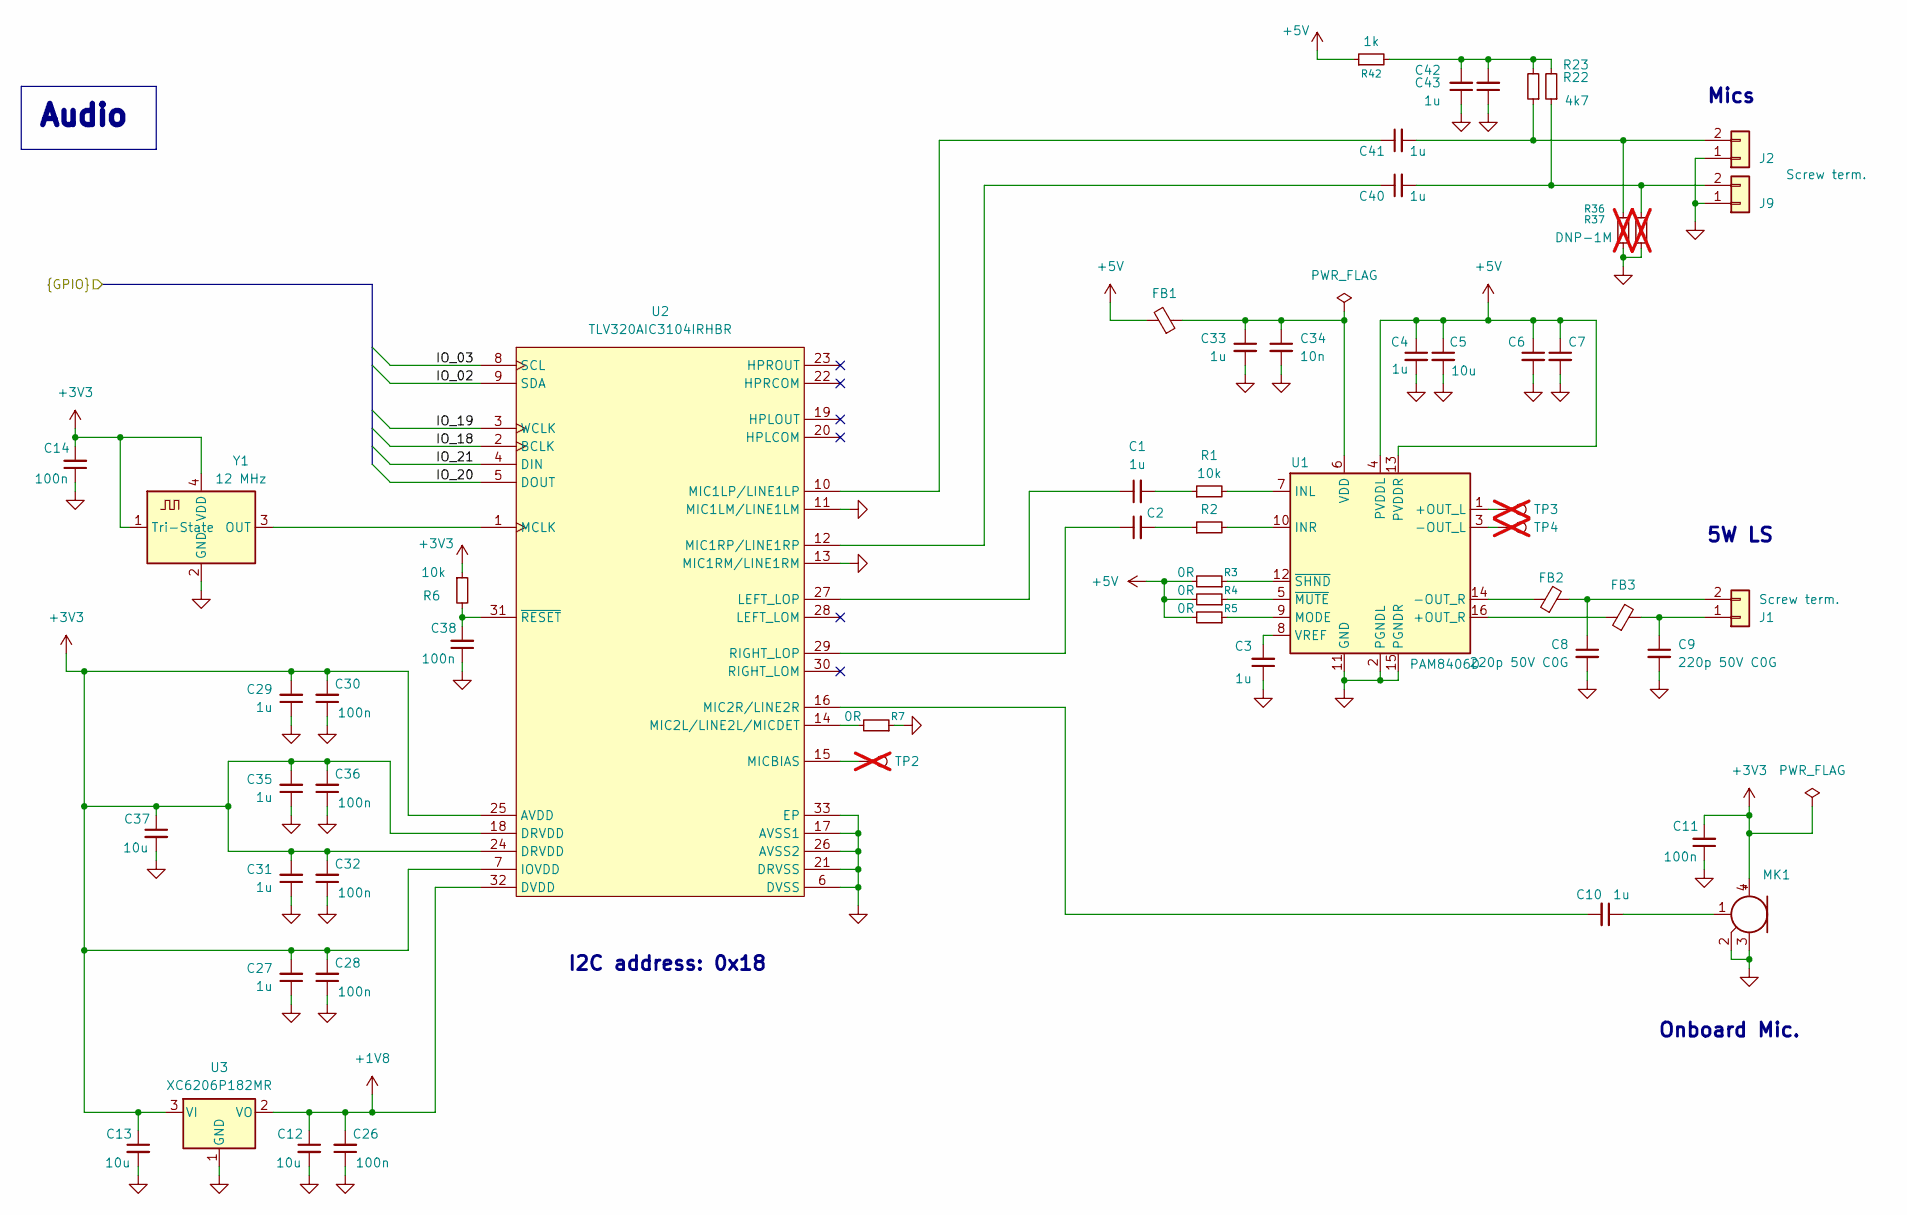
[picture p15: schematic audio.kicad_sch, elec RPI Robot HAT]

Parts:
C1: 1u; C_0402_1005Metric_C1; LCSC Part C52923
C2: 1u; C_0402_1005Metric_C2; LCSC Part C52923
C3: 1u; C_0402_1005Metric_C3; LCSC Part C52923
C4: 1u; C_0402_1005Metric_C4; LCSC Part C52923
C5: 10u; C_0603_1608Metric_C5; LCSC Part C1691
C6: 1u; C_0402_1005Metric_C6; LCSC Part C52923
C7: 10u; C_0603_1608Metric_C7; LCSC Part C1691
C8: 220p 50V C0G; C_0402_1005Metric_C8; LCSC Part C71693
C9: 220p 50V C0G; C_0402_1005Metric_C9; LCSC Part C71693
C10: 1u; C_0402_1005Metric_C10; LCSC Part C52923
C11: 100n; C_0402_1005Metric_C11; LCSC Part C307331
C12: 10u; C_0603_1608Metric_C12; LCSC Part C1691
C13: 10u; C_0603_1608Metric_C13; LCSC Part C1691
C14: 100n; C_0402_1005Metric_C14; LCSC Part C307331
C26: 100n; C_0402_1005Metric_C26; LCSC Part C307331
C27: 1u; C_0402_1005Metric_C27; LCSC Part C52923
C28: 100n; C_0402_1005Metric_C28; LCSC Part C307331
C29: 1u; C_0402_1005Metric_C29; LCSC Part C52923
C30: 100n; C_0402_1005Metric_C30; LCSC Part C307331
C31: 1u; C_0402_1005Metric_C31; LCSC Part C52923
C32: 100n; C_0402_1005Metric_C32; LCSC Part C307331
C33: 1u; C_0402_1005Metric_C33; LCSC Part C52923
C34: 10n; C_0402_1005Metric_C34; LCSC Part C15195
C35: 1u; C_0402_1005Metric_C35; LCSC Part C52923
C36: 100n; C_0402_1005Metric_C36; LCSC Part C307331
C37: 10u; C_0603_1608Metric_C37; LCSC Part C1691
C38: 100n; C_0402_1005Metric_C38; LCSC Part C307331
C40: 1u; C_0402_1005Metric_C40; LCSC Part C52923
C41: 1u; C_0402_1005Metric_C41; LCSC Part C52923
C42: 1u; C_0402_1005Metric_C42; LCSC Part C52923
C43: 1u; C_0402_1005Metric_C43; LCSC Part C52923
FB1: 0.3A 600R@100MHz; L_0402_1005Metric_FB1; LCSC Part C76884
FB2: 2A - 120R@100MHz; L_0402_1005Metric_FB2; LCSC Part C88970
FB3: 2A - 120R@100MHz; L_0402_1005Metric_FB3; LCSC Part C88970
J1: Screw term.; CONN-TH_DB125-2.54-2P-GN_J1; LCSC Part C918120
J2: Screw term.; CONN-TH_DB125-2.54-2P-GN_J2; LCSC Part C918120
J9: Screw term.; CONN-TH_DB125-2.54-2P-GN_J9; LCSC Part C918120
MK1: Microphone_MEMS; MIC-SMD_4P-L2.8-W1.9-P1.84-TL_MK1; LCSC Part C7587901
R1: 10k; R_0402_1005Metric_R1; LCSC Part C25744
R2: 10k; R_0402_1005Metric_R2; LCSC Part C25744
R3: 0R; R_0402_1005Metric_R3; LCSC Part C17168
R4: 0R; R_0402_1005Metric_R4; LCSC Part C17168
R5: 0R; R_0402_1005Metric_R5; LCSC Part C17168
R6: 10k; R_0402_1005Metric_R6; LCSC Part C25744
R7: 0R; R_0402_1005Metric_R7; LCSC Part C17168
R22: 4k7; R_0402_1005Metric_R22; LCSC Part C105871
R23: 4k7; R_0402_1005Metric_R23; LCSC Part C105871
R36: DNP-1M; R_0402_1005Metric_R36; not fitted
R37: DNP-1M; R_0402_1005Metric_R37; not fitted
R42: 1k; R_0402_1005Metric_R42; LCSC Part C105637
TP2: TestPoint; TestPoint_Loop_D2.50mm_Drill1.0mm_LowProfile_TP2; not fitted
TP3: TestPoint; TestPoint_Loop_D2.50mm_Drill1.0mm_LowProfile_TP3; not fitted
TP4: TestPoint; TestPoint_Loop_D2.50mm_Drill1.0mm_LowProfile_TP4; not fitted
U1: PAM8406D; SOIC-16_3.9x9.9mm_P1.27mm_U1; LCSC Part C86270
U2: TLV320AIC3104IRHBR; VQFN-32-1EP_5x5mm_P0.5mm_EP3.5x3.5mm_U2; LCSC Part C181753
U3: XC6206P182MR; SOT-23-3_U3; LCSC Part C347373
Y1: 12 MHz; Oscillator_SMD_Abracon_ASDMB-4Pin_2.5x2.0mm_Y1; LCSC Part C7425459

Connections:
+1V8: C12.1, C26.2, U2.32 (DVDD), U3.2 (VO)
+3V3: C11.2, C13.1, C14.2, C27.2, C28.2, C29.2, C30.2, C31.2, C32.2, C35.2, C36.2, C37.1, MK1.4 (+), R6.1, U2.7 (IOVDD), U2.18 (DRVDD), U2.24 (DRVDD), U2.25 (AVDD), U3.3 (VI), Y1.1 (Tri-State), Y1.4 (VDD); also elsewhere on the board
+5V: C4.1, C5.1, C6.1, C7.1, FB1.2, R3.2, R4.2, R5.2, R42.1, U1.4 (PVDDL), U1.13 (PVDDR); also elsewhere on the board
/Schematic/Audio/IO_02: U2.9 (SDA); also elsewhere on the board
/Schematic/Audio/IO_03: U2.8 (SCL); also elsewhere on the board
/Schematic/Audio/IO_18: U2.2 (BCLK); also elsewhere on the board
/Schematic/Audio/IO_19: U2.3 (WCLK); also elsewhere on the board
/Schematic/Audio/IO_20: U2.5 (DOUT); also elsewhere on the board
/Schematic/Audio/IO_21: U2.4 (DIN); also elsewhere on the board
GND: C3.1, C4.2, C5.2, C6.2, C7.2, C8.2, C9.2, C11.1, C12.2, C13.2, C14.1, C26.1, C27.1, C28.1, C29.1, C30.1, C31.1, C32.1, C33.2, C34.2, C35.1, C36.1, C37.2, C38.1, C42.1, C43.1, J2.1, J9.1, MK1.2 (-), MK1.3 (-), R7.1, R36.1, R37.1, U1.2 (PGNDL), U1.11 (GND), U1.15 (PGNDR), U2.6 (DVSS), U2.11 (MIC1LM/LINE1LM), U2.13 (MIC1RM/LINE1RM), U2.17 (AVSS1), U2.21 (DRVSS), U2.26 (AVSS2), U2.33 (EP), U3.1 (GND), Y1.2 (GND); also elsewhere on the board
unnamed: C1.2, R1.1
unnamed: C2.2, R2.1
unnamed: C10.1, MK1.1 (-)
unnamed: C42.2, C43.2, R22.2, R23.2, R42.2
unnamed: C9.1, FB3.2, J1.1
unnamed: C8.1, FB2.2, J1.2
unnamed: C41.2, J2.2, R22.1, R36.2
unnamed: C40.2, J9.2, R23.1, R37.2
unnamed: TP3.1, U1.1 (+OUT_L)
unnamed: FB3.1, U1.16 (+OUT_R)
unnamed: TP4.1, U1.3 (-OUT_L)
unnamed: FB2.1, U1.14 (-OUT_R)
unnamed: R1.2, U1.7 (INL)
unnamed: R2.2, U1.10 (INR)
unnamed: R5.1, U1.9 (MODE)
unnamed: C33.1, C34.1, FB1.1, U1.6 (VDD)
unnamed: C3.2, U1.8 (VREF)
unnamed: R4.1, U1.5 (~MUTE)
unnamed: R3.1, U1.12 (~SHND)
unnamed: C1.1, U2.27 (LEFT_LOP)
unnamed: U2.1 (MCLK), Y1.3 (OUT)
unnamed: C41.1, U2.10 (MIC1LP/LINE1LP)
unnamed: C40.1, U2.12 (MIC1RP/LINE1RP)
unnamed: R7.2, U2.14 (MIC2L/LINE2L/MICDET)
unnamed: C10.2, U2.16 (MIC2R/LINE2R)
unnamed: TP2.1, U2.15 (MICBIAS)
unnamed: C2.1, U2.29 (RIGHT_LOP)
unnamed: C38.2, R6.2, U2.31 (~RESET)

Notes on the sheet:
Onboard Mic.
5W LS
Mics
I2C address: 0x18
Audio

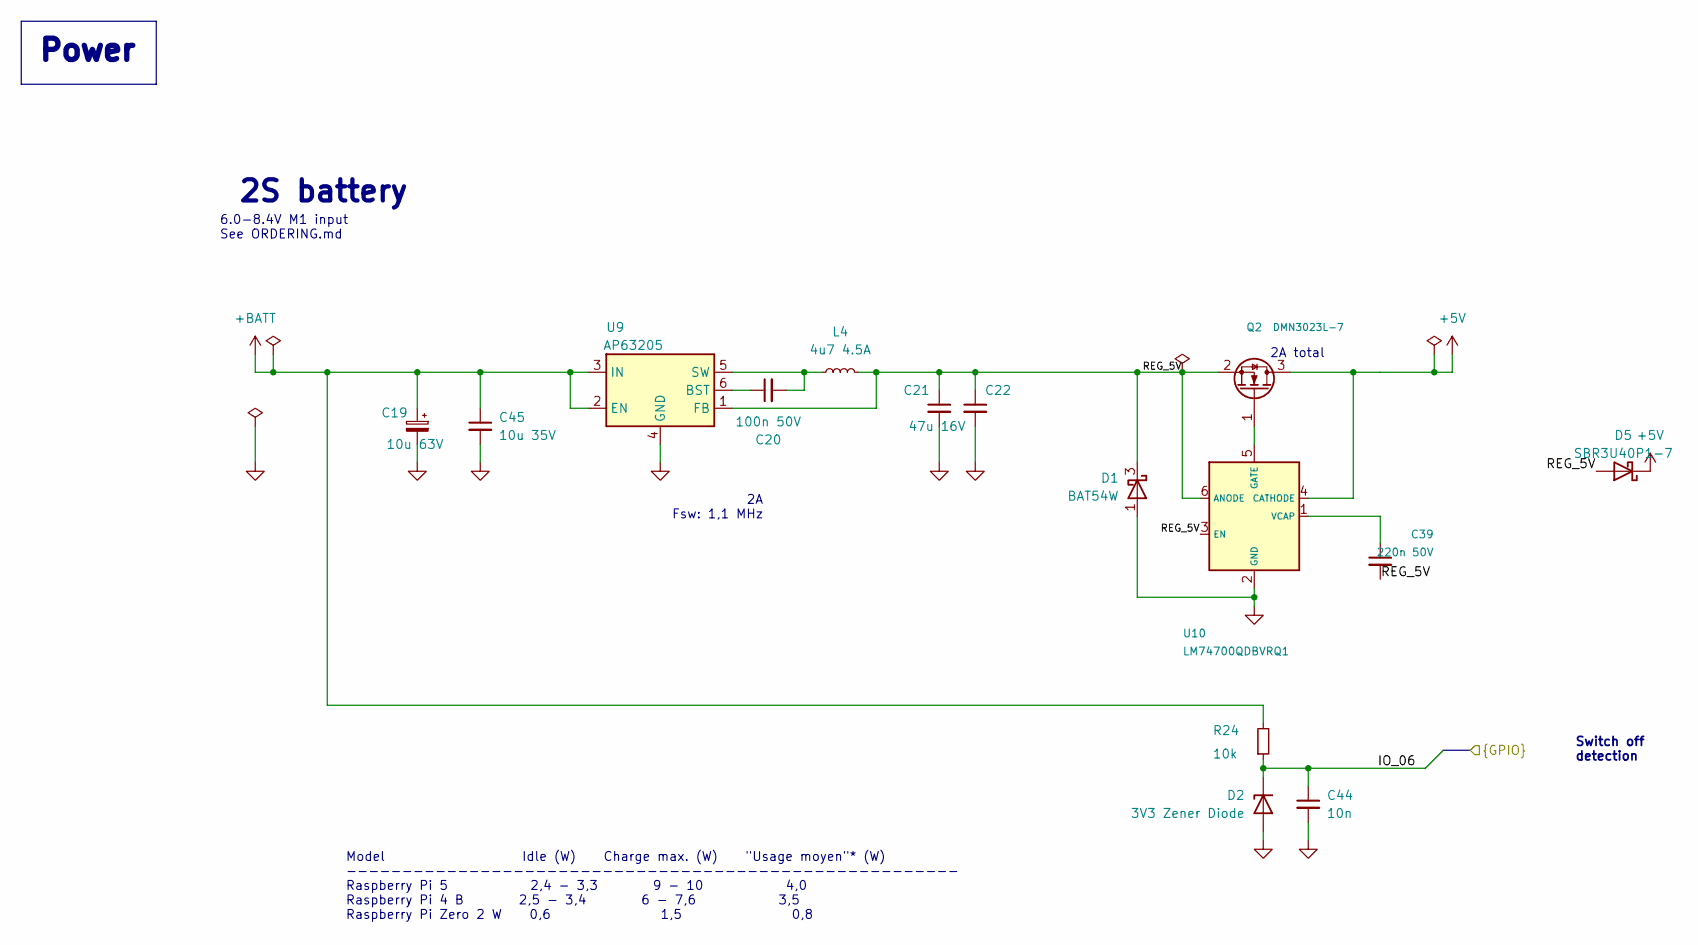
[picture p16: schematic power.kicad_sch, elec RPI Robot HAT]

Parts:
C19: 10u 63V; Panasonic_FK_D_6.3x5.8_C19
C20: 100n 50V; C_0402_1005Metric_C20; LCSC Part C307331
C21: 47u 16V; C_1206_C21; LCSC Part C385047
C22: 47u 16V; C_1206_C22; LCSC Part C385047
C39: 220n 50V; C_0805_C39; LCSC Part C86042
C44: 10n; C_0402_1005Metric_C44; LCSC Part C15195
C45: 10u 35V; C_0805_2012Metric_C45; LCSC Part C33546007
D1: BAT54W; SOT-323_SC-70_D1
D2: 3V3 Zener Diode; D_SOD-123_D2; LCSC Part C19077392
D5: SBR3U40P1-7; D_PowerDI123_D5; LCSC Part C97127
L4: 4u7 4.5A; Eaton_SDCHA1V6045_L4
Q2: DMN3023L-7; TSOT-23_Q2; LCSC Part C443825
R24: 10k; R_0402_1005Metric_R24; LCSC Part C25744
U9: AP63205; TSOT-23-6_U9; LCSC Part C2071056
U10: LM74700QDBVRQ1; LM74700_DBV_U10; LCSC Part C2941042

Connections:
+5V: D5.1 (K), Q2.3 (D), U10.4 (CATHODE); also elsewhere on the board
+BATT: C19.1, C45.1, R24.2, U9.2 (EN), U9.3 (IN); also elsewhere on the board
/Schematic/Audio/IO_06: C44.1, D2.1 (K), R24.1; also elsewhere on the board
/Schematic/Power/REG_5V: C21.1, C22.1, C39.2, D1.3 (K), D5.2 (A), L4.1, Q2.2 (S), U9.1 (FB), U10.3 (EN), U10.6 (ANODE)
GND: C19.2, C21.2, C22.2, C44.2, C45.2, D1.1 (A), D2.2 (A), U9.4 (GND), U10.2 (GND); also elsewhere on the board
unnamed: Q2.1 (G), U10.5 (GATE)
unnamed: C20.1, U9.6 (BST)
unnamed: C20.2, L4.2, U9.5 (SW)
unnamed: C39.1, U10.1 (VCAP)

Notes on the sheet:
Switch off detection
2A total
2S battery
Model Idle (W) Charge max. (W) "Usage moyen"* (W) ------------------------------------------------------- Raspberry Pi 5 2,4 - 3,3 9 - 10 4,0 Raspberry Pi 4 B 2,5 - 3,4 6 - 7,6 3,5 Raspberry Pi Zero 2 W 0,6 1,5 0,8
6.0-8.4V M1 input See ORDERING.md
2A Fsw: 1,1 MHz
Power

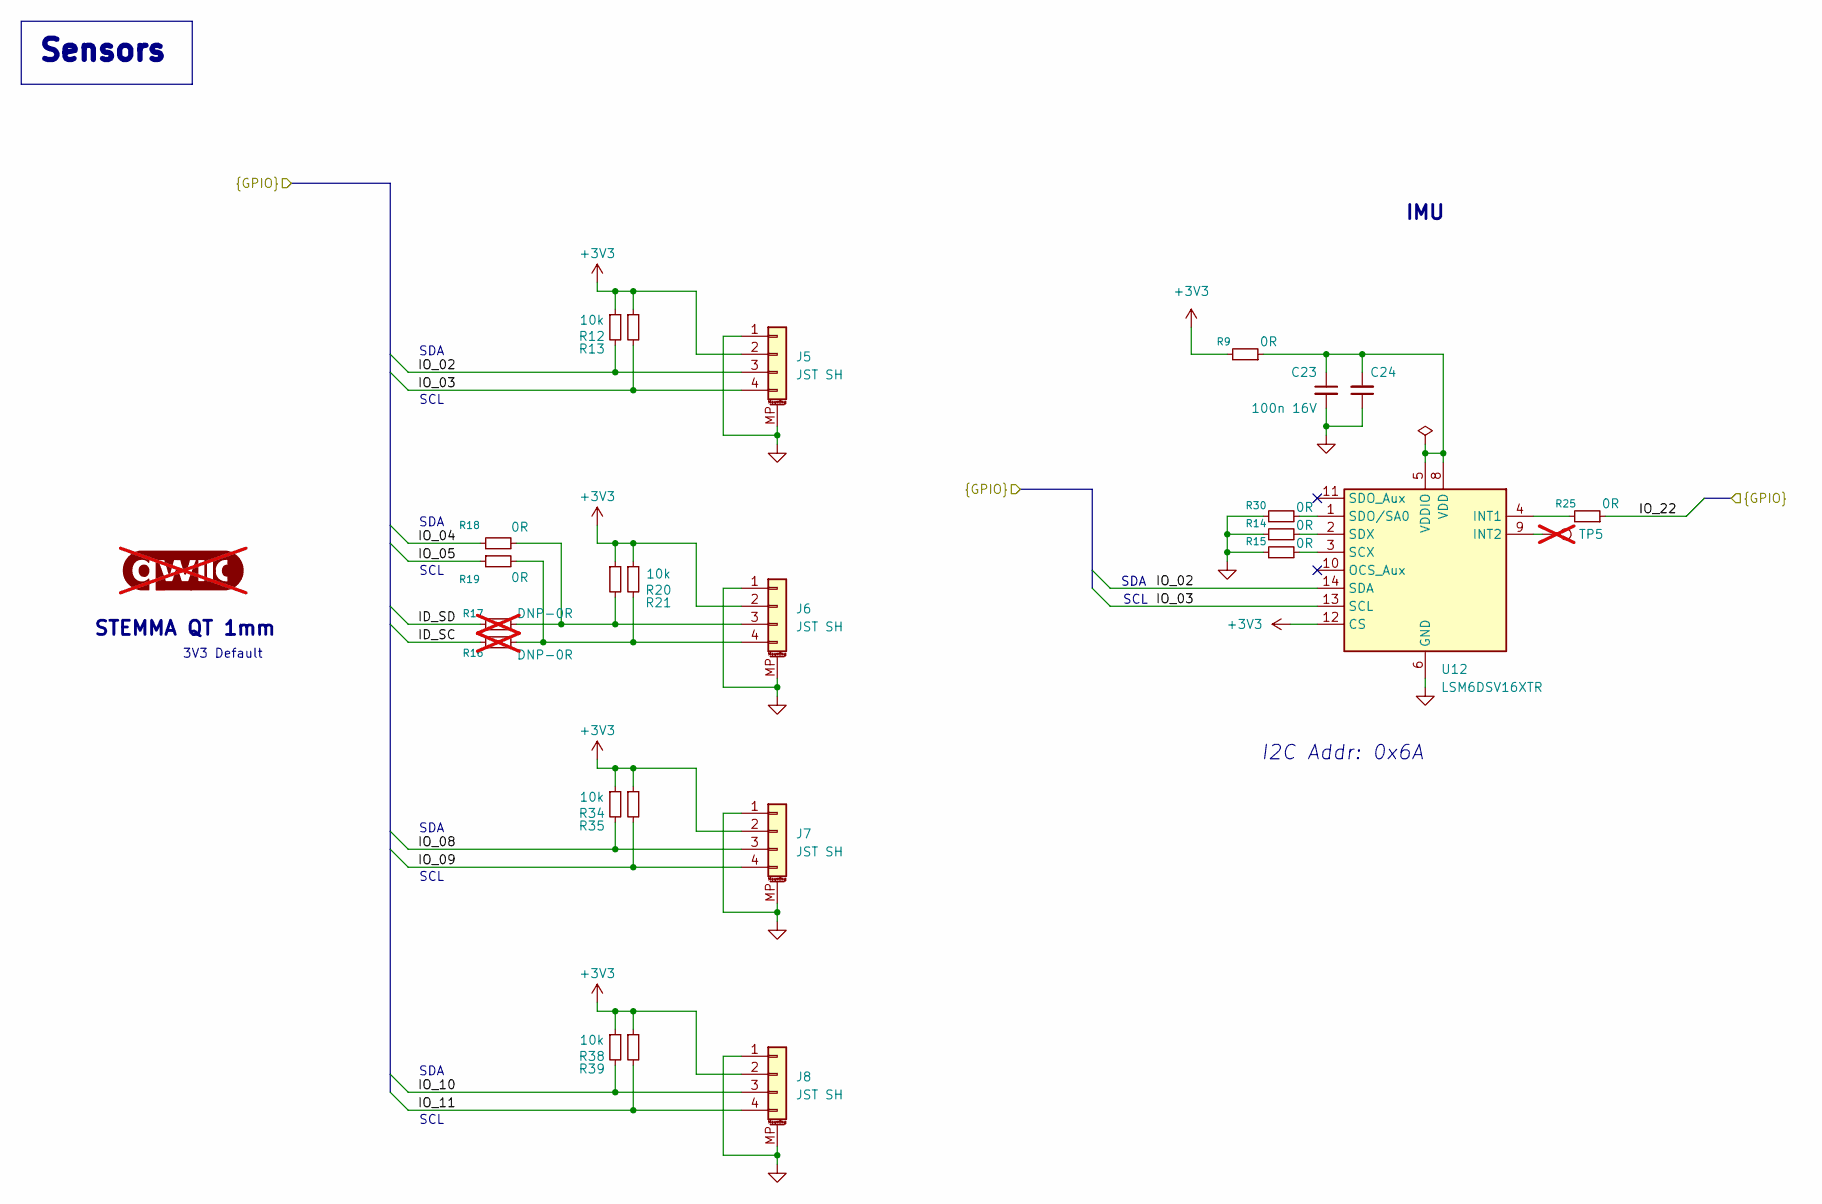
[picture p17: schematic sensors.kicad_sch, elec RPI Robot HAT]

Parts:
C23: 100n 16V; C_0402_1005Metric_C23; LCSC Part C1525
C24: 100n 16V; C_0402_1005Metric_C24; LCSC Part C1525
G1: qwiic_Logo; Logo_qwiic_5mm_G1; not fitted
J5: JST SH; JST_SH_BM04B-SRSS-TB_1x04-1MP_P1.00mm_Vertical_J5; LCSC Part C160390
J6: JST SH; JST_SH_BM04B-SRSS-TB_1x04-1MP_P1.00mm_Vertical_J6; LCSC Part C160390
J7: JST SH; JST_SH_BM04B-SRSS-TB_1x04-1MP_P1.00mm_Vertical_J7; LCSC Part C160390
J8: JST SH; JST_SH_BM04B-SRSS-TB_1x04-1MP_P1.00mm_Vertical_J8; LCSC Part C160390
R9: 0R; R_0402_1005Metric_R9; LCSC Part C17168
R12: 10k; R_0402_1005Metric_R12; LCSC Part C25744
R13: 10k; R_0402_1005Metric_R13; LCSC Part C25744
R14: 0R; R_0402_1005Metric_R14; LCSC Part C17168
R15: 0R; R_0402_1005Metric_R15; LCSC Part C17168
R16: DNP-0R; R_0402_1005Metric_R16; not fitted
R17: DNP-0R; R_0402_1005Metric_R17; not fitted
R18: 0R; R_0402_1005Metric_R18; LCSC Part C17168
R19: 0R; R_0402_1005Metric_R19; LCSC Part C17168
R20: 10k; R_0402_1005Metric_R20; LCSC Part C25744
R21: 10k; R_0402_1005Metric_R21; LCSC Part C25744
R25: 0R; R_0402_1005Metric_R25; LCSC Part C17168
R30: 0R; R_0402_1005Metric_R30; LCSC Part C17168
R34: 10k; R_0402_1005Metric_R34; LCSC Part C25744
R35: 10k; R_0402_1005Metric_R35; LCSC Part C25744
R38: 10k; R_0402_1005Metric_R38; LCSC Part C25744
R39: 10k; R_0402_1005Metric_R39; LCSC Part C25744
TP5: TestPoint; TestPoint_Pad_D1.0mm_TP5; not fitted
U12: LSM6DSV16XTR; LSM6DSV16X_PCBWay_020_U12; LCSC Part C5267406

Connections:
+3V3: J5.2, J6.2, J7.2, J8.2, R9.2, R12.1, R13.1, R20.1, R21.1, R34.1, R35.1, R38.1, R39.1, U12.12 (CS); also elsewhere on the board
/Schematic/Audio/ID_SC: R16.1; also elsewhere on the board
/Schematic/Audio/ID_SD: R17.1; also elsewhere on the board
/Schematic/Audio/IO_02: J5.3, R12.2, U12.14 (SDA); also elsewhere on the board
/Schematic/Audio/IO_03: J5.4, R13.2, U12.13 (SCL); also elsewhere on the board
/Schematic/Audio/IO_04: R18.1; also elsewhere on the board
/Schematic/Audio/IO_05: R19.1; also elsewhere on the board
/Schematic/Audio/IO_08: J7.3, R34.2; also elsewhere on the board
/Schematic/Audio/IO_09: J7.4, R35.2; also elsewhere on the board
/Schematic/Audio/IO_10: J8.3, R38.2; also elsewhere on the board
/Schematic/Audio/IO_11: J8.4, R39.2; also elsewhere on the board
/Schematic/Audio/IO_22: R25.1; also elsewhere on the board
GND: C23.2, C24.1, J5.1, J5.MP (MountPin), J6.1, J6.MP (MountPin), J7.1, J7.MP (MountPin), J8.1, J8.MP (MountPin), R14.1, R15.1, R30.1, U12.6 (GND), U12.7 (GND); also elsewhere on the board
unnamed: J6.3, R17.2, R18.2, R20.2
unnamed: J6.4, R16.2, R19.2, R21.2
unnamed: R25.2, U12.4 (INT1)
unnamed: TP5.1, U12.9 (INT2)
unnamed: R15.2, U12.3 (SCX)
unnamed: R30.2, U12.1 (SDO/SA0)
unnamed: R14.2, U12.2 (SDX)
unnamed: C23.1, C24.2, R9.1, U12.5 (VDDIO), U12.8 (VDD)

Notes on the sheet:
SCL
SDA
STEMMA QT 1mm
3V3 Default
IMU
I2C Addr: 0x6A
Sensors

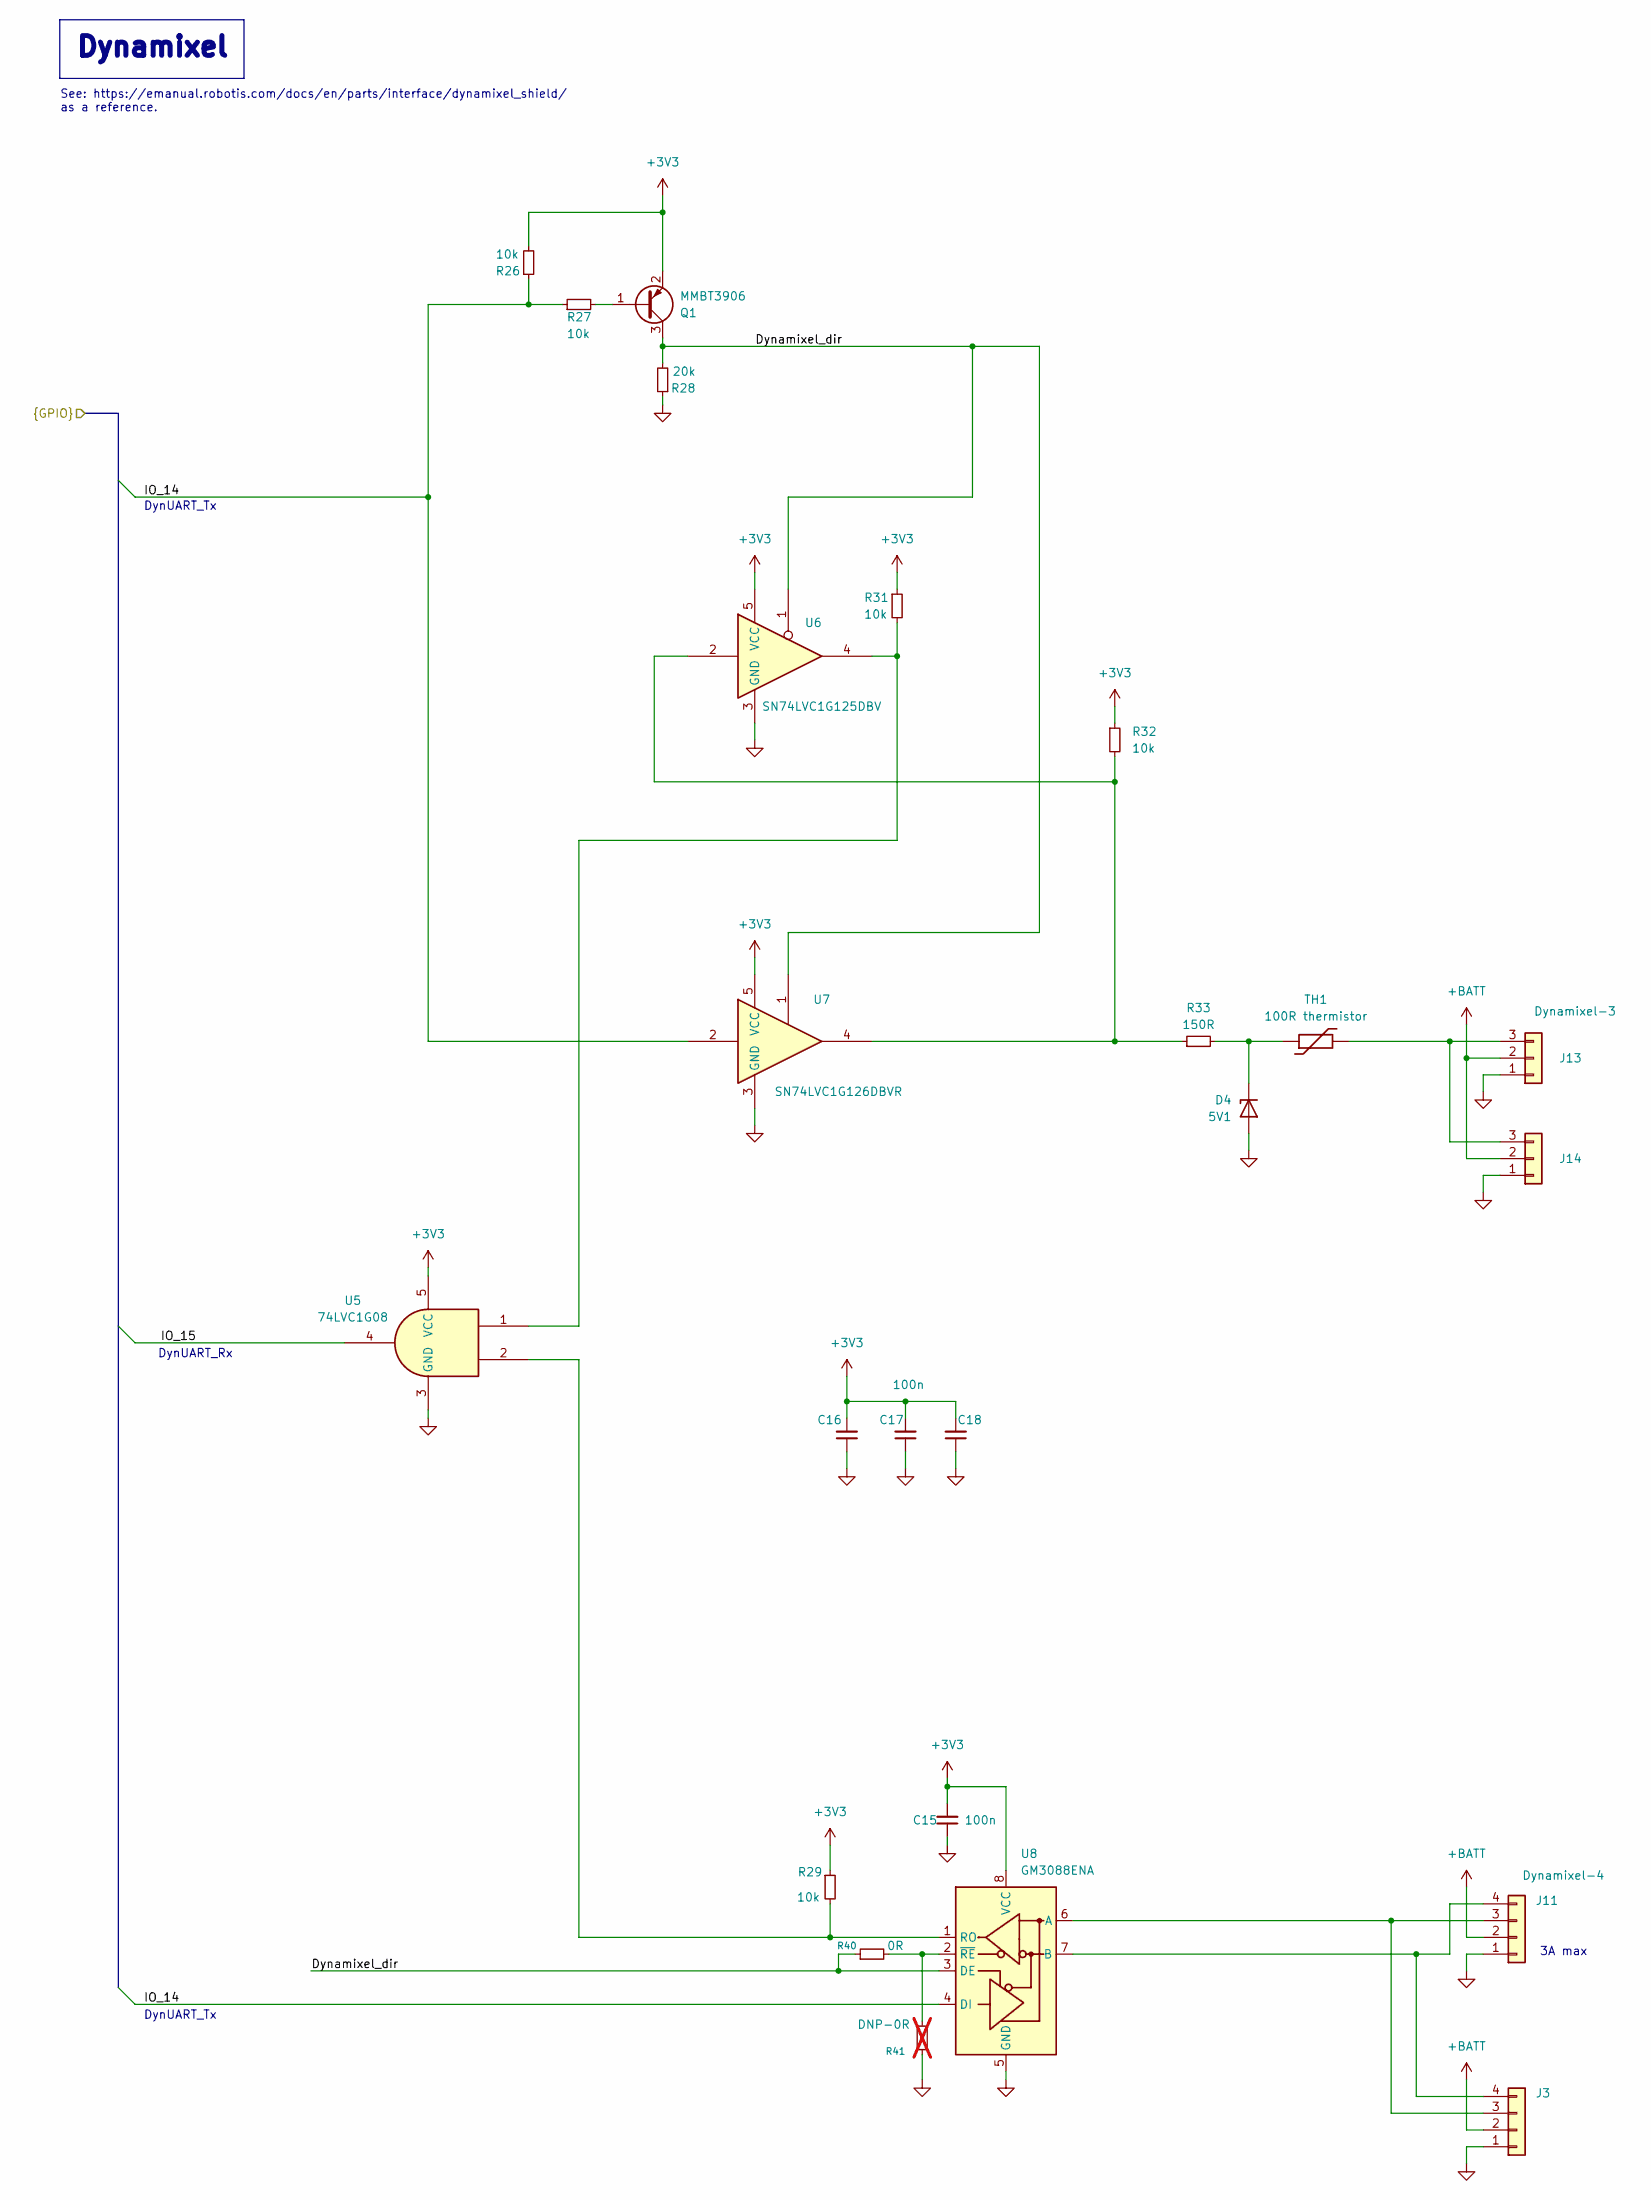
[picture p18: schematic dynamixel.kicad_sch, elec RPI Robot HAT]

Parts:
C15: 100n; C_0402_1005Metric_C15; LCSC Part C307331
C16: 100n; C_0402_1005Metric_C16; LCSC Part C307331
C17: 100n; C_0402_1005Metric_C17; LCSC Part C307331
C18: 100n; C_0402_1005Metric_C18; LCSC Part C307331
D4: 5V1; D_SOD-323_D4; LCSC Part C151348
J3: Dynamixel-4; JST_EH_B4B-EH-A_1x04_P2.50mm_Vertical_J3; LCSC Part C160258
J11: Dynamixel-4; JST_EH_B4B-EH-A_1x04_P2.50mm_Vertical_J11; LCSC Part C160258
J13: Dynamixel-3; JST_EH_B3B-EH-A_1x03_P2.50mm_Vertical_J13; LCSC Part C160259
J14: Dynamixel-3; JST_EH_B3B-EH-A_1x03_P2.50mm_Vertical_J14; LCSC Part C160259
Q1: MMBT3906; SOT-23_Q1; LCSC Part C727128
R26: 10k; R_0402_1005Metric_R26; LCSC Part C25744
R27: 10k; R_0402_1005Metric_R27; LCSC Part C25744
R28: 20k; R_0402_1005Metric_R28; LCSC Part C25765
R29: 10k; R_0402_1005Metric_R29; LCSC Part C25744
R31: 10k; R_0402_1005Metric_R31; LCSC Part C25744
R32: 10k; R_0402_1005Metric_R32; LCSC Part C25744
R33: 150R; R_0402_1005Metric_R33; LCSC Part C2909321
R40: 0R; R_0402_1005Metric_R40; LCSC Part C17168
R41: DNP-0R; R_0402_1005Metric_R41; not fitted
TH1: 100R thermistor; R_0603_1608Metric_TH1; LCSC Part C913703
U5: 74LVC1G08; SOT-23-5_U5; LCSC Part C7666
U6: SN74LVC1G125DBV; SOT-23-5_U6; LCSC Part C23654
U7: SN74LVC1G126DBVR; SOT-23-5_U7; LCSC Part C7834
U8: GM3088ENA; DFN-8-1EP_3x3mm_P0.65mm_EP1.2x2.15mm_U8; LCSC Part C49423279

Connections:
+3V3: C15.2, C16.2, C17.2, C18.2, Q1.2 (E), R26.2, R29.1, R31.1, R32.1, U5.5 (VCC), U6.5 (VCC), U7.5 (VCC), U8.8 (VCC); also elsewhere on the board
+BATT: J3.2, J11.2, J13.2, J14.2; also elsewhere on the board
/Schematic/Audio/IO_14: R26.1, R27.1, U7.2, U8.4 (DI); also elsewhere on the board
/Schematic/Audio/IO_15: U5.4; also elsewhere on the board
/Schematic/Dynamixel/Dynamixel_dir: Q1.3 (C), R28.2, R40.1, U6.1, U7.1, U8.3 (DE)
GND: C15.1, C16.1, C17.1, C18.1, D4.2 (A), J3.1, J11.1, J13.1, J14.1, R28.1, R41.1, U5.3 (GND), U6.3 (GND), U7.3 (GND), U8.5 (GND); also elsewhere on the board
unnamed: D4.1 (K), R33.2, TH1.1
unnamed: J3.3, J11.3, U8.6 (A)
unnamed: J3.4, J11.4, U8.7 (B)
unnamed: J13.3, J14.3, TH1.2
unnamed: Q1.1 (B), R27.2
unnamed: R31.2, U5.1, U6.4
unnamed: R32.2, R33.1, U6.2, U7.4
unnamed: R29.2, U5.2, U8.1 (RO)
unnamed: R40.2, R41.2, U8.2 (~RE)

Notes on the sheet:
DynUART_Tx
DynUART_Rx
See: https://emanual.robotis.com/docs/en/parts/interface/dynamixel_shield/ as a reference.
3A max
Dynamixel

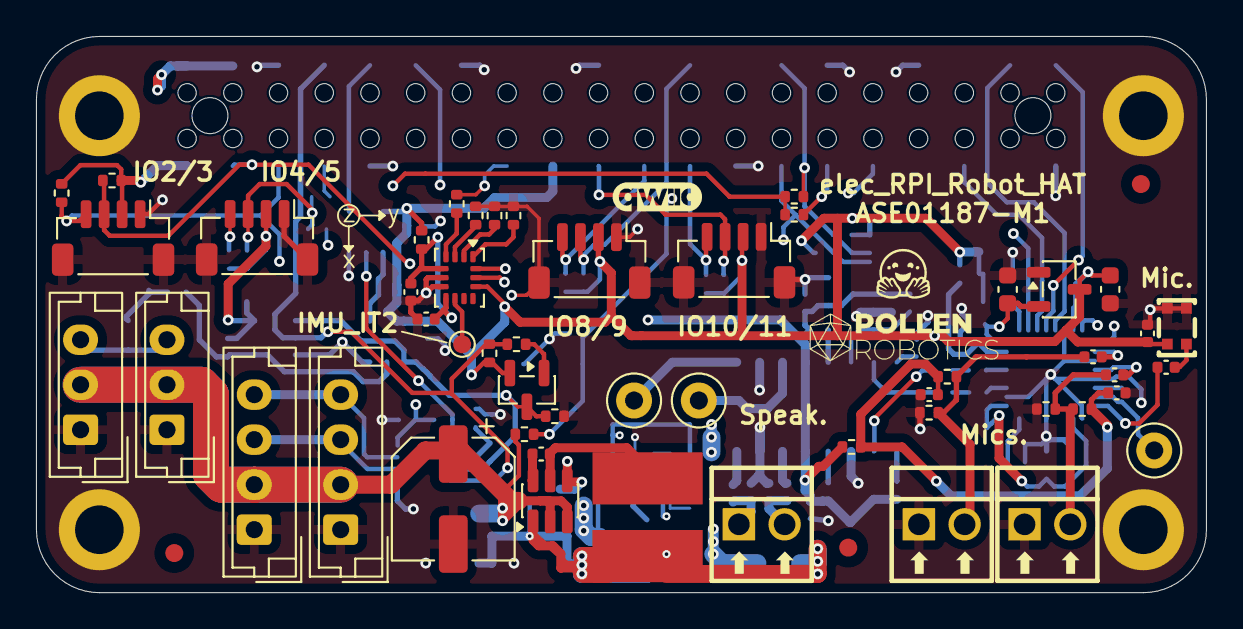
[picture p19: board elec_RPI_Robot_HAT.kicad_pcb from above]

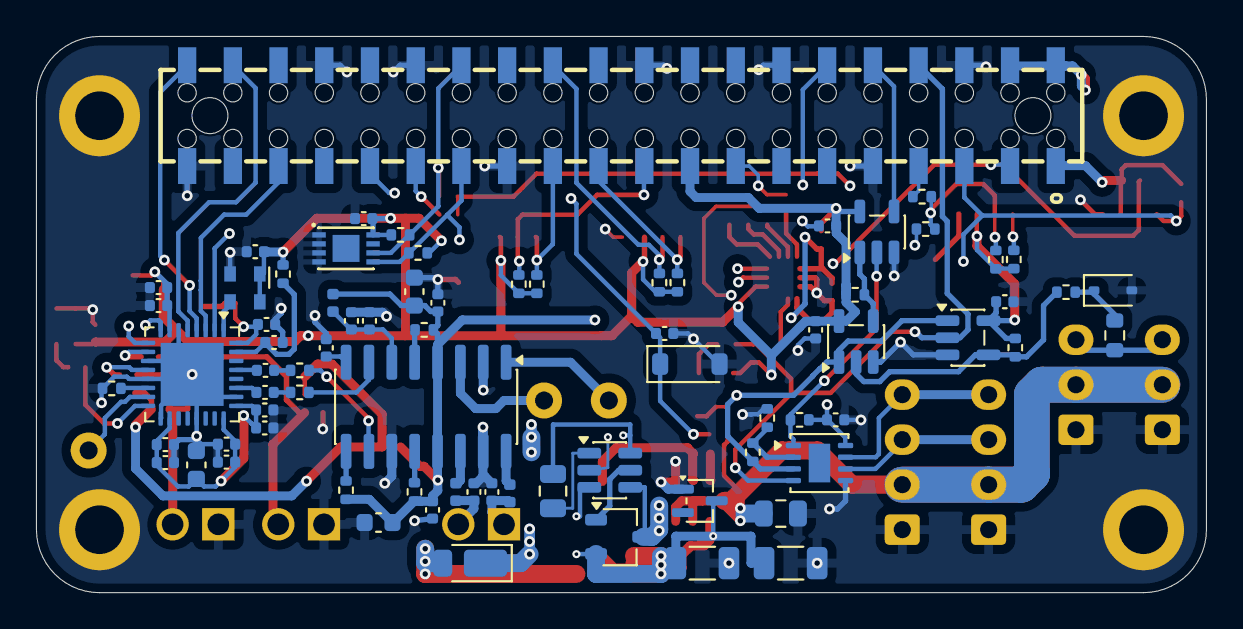
[picture p20: board elec_RPI_Robot_HAT.kicad_pcb from below]

Board: 4 copper layers, 65.0 x 30.9 mm, 132 parts (75 on the bottom side), 74 nets.
