mikaelrobertlindberg/elec_RPI_Robot_HAT/(commit log)

2026-11-09 Create PCBWay DFM candidate with corrected audio caps and reproducible libraries
    [audio.kicad_sch, dynamixel.kicad_sch, elec_RPI_Robot_HAT.kicad_pcb, elec_RPI_Robot_HAT.kicad_sch, main.kicad_sch, power.kicad_sch, sensors.kicad_sch]
2026-11-09 Release D1-M1 ten-board PCBA prototype package with qualified power ECO
    [BOM_PCBA_10.csv, Do_not_populate.csv, Sourcing_2026-11-09.csv, audio.kicad_sch, dynamixel.kicad_sch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]
2026-11-11 Restore isolated U8 exposed pad and deliver verified M2 ECO
    [BOM_PCBA_10.csv, Do_not_populate.csv, Sourcing_2026-11-09.csv, dynamixel.kicad_sch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]
